Pilzkoma/PiTrac/sp1_vision/strobe_runs/README.md

# Strobe-lit captures

Contents:
- `2026-11-10_first_flash/` — where a flash lands, how bright (below).
- `2026-11-11_triangulation/` — first stereo measurement under the flash
  (last section).

Measured with `sp1_vision/strobe_capture.py`: both cameras stream at 120 fps,
the Teensy fires one pulse from Pin 29 mid-stream, and every frame is logged
with its arrival time after the fire and how far it rose above the run's
ambient baseline. Raw output goes to `/tmp/strobe_<time>/` on the Jetson; only
what a conclusion rests on is kept here.

## 2026-11-10 — first flash, `2026-11-10_first_flash/`

Room light on, ball on the floor in front of the unit, nobody in view, the
arrays' photocells covered. 24 runs: exposure 8 / 4 / 1 ms × single pulse
0.5 / 2 ms × 4 repeats. `frames.csv` holds every frame; the PNGs are run 02
(8 ms exposure, 0.5 ms flash, both cameras) and run 22 (1 ms, 2 ms, cam1).

### The flash swamps room light

Ball centre, mean grey level (sensor black level ≈ 22):

| exposure | flash | cam1 | cam2 |
|---|---|---|---|
| 1 ms, room light only | — | 24 | 22 |
| 8 ms, room light only | — | 36 | 25 |
| 8 ms | 0.5 ms | 237 (saturated) | 118 |
| 8 ms | 2 ms | 244 (saturated) | 234 |
| 1 ms | 2 ms | 244 (saturated) | 131 |

Per unit time the flash puts roughly 50–100× more light on the ball than the
room lamps: a 0.5 ms pulse adds ~95 grey levels at cam2, a whole millisecond of
room light ~2. At 1 ms exposure the room is near black and the ball white.
Even at 8 ms exposure the flash is ~8× the ambient on the ball. Direct sun in
the garage is still untested.

**cam1 saturates on the shortest pulse; cam2 gets about half** — in this run.
It was not the arrays: the right-hand board's photocell was still dimming it
through the tape. With the photocells removed the two cameras agree to 1–2 %
(next section).

### Where the flash lands

- Fire → frame arrival in Python: **11–20 ms**. The 8 ms spread is the frame
  period; the offset is readout + USB + decode.
- **8 ms exposure catches every flash** (16/16), once split across two frames.
- Short exposures catch it by chance, about (exposure + pulse) / 8.33 ms:
  1 ms + 0.5 ms hit 1 of 8 camera-runs.
- **The two cameras are not in phase.** At short exposure one camera often saw
  the flash and the other did not. Triangulation needs both to see the same
  flash, so either the exposure stays long (~8 ms, flash still dominant) or the
  strobe fires a train covering a whole frame period. This is the input for
  `WaitForCam2Trigger`.

### Capture details learned on the way

- Continuous reading needs `CAP_PROP_BUFFERSIZE 2`: with 1 the stream halves to
  ~68 fps, because the frame arriving during a fetch has nowhere to go. The
  held-back-frame defect (CLAUDE.md) only concerns on-demand reads.
- `CAP_PROP_POS_MSEC` (V4L2 buffer timestamp) is unusable here: 4 ms steps and
  occasional jumps of hundreds of ms. Arrival time runs at a steady 8.0 ms.
- Frames are kept as raw MJPEG while streaming (`CAP_PROP_CONVERT_RGB 0`) and
  decoded afterwards; decoding two 120 fps streams in Python drops frames.

### Hardware faults found the same evening

All three made the flash look absent or random before this run:

1. **Two-pole connector on the LED supply** had an intermittent contact —
   replaced with two separate crimps.
2. **Photocells on the Cenpek boards** dim or cut the LEDs in room light (the
   source of the earlier "one array much weaker" and flicker). Covered for
   this run; to be removed for good, since tape will not hold against garage
   daylight.
3. **Trigger line Pin 29 → Teensy Pin 2** dropped out twice and came back while
   probing. To be re-soldered or clamped. Jetson Pin 29 itself was verified
   switching 0 ↔ 3.3 V on the header.

A flash that comes back from a hand or the calibration board held near the
lens reads up to +85 grey levels on the whole frame, so judge strobe
brightness only with an empty scene.

## 2026-11-11 — after the fixes

Photocells desoldered from both boards, trigger line re-soldered. Same scene,
8 ms exposure, 12 runs (raw data only on the Jetson, `/tmp/strobe_run3`).
Both cameras run identical V4L2 settings (gain 0, gamma 100, contrast 32).

- **Trigger: 12/12 flashes arrived, in both cameras.**
- Ball centre (dark level ≈ 24):

  | flash | cam1 | cam2 |
  |---|---|---|
  | 0.1 ms | 140 | 138–139 |
  | 0.3 ms | 238–239 | 237 (once 141) |
  | 0.5 ms | 244 (saturated) | 244 (saturated) |

- **The cameras agree to 1–2 %**; the arrays need no balancing.
- **0.1 ms is already enough** — mid-range on the ball; 0.3 ms clips. Short
  is what a moving ball needs anyway (6 mm of travel per 0.1 ms at 60 m/s).
- The one 141 at 0.3 ms is a flash straddling the ~0.33 ms gap between an
  8.0 ms exposure and the 8.33 ms frame period — about one flash in twenty
  loses part of its light that way.

## 2026-11-11 — the cameras' own processing changes what they report

Brighter room lamps (one lighting the ball from the right, one from above),
same flash, ball in the same place to 5 px. The flash's **contribution** on the
ball — flash frame minus ambient frame, which more ambient light must not
change — dropped:

| 0.1 ms flash, 8 ms exposure | cam1 | cam2 |
|---|---|---|
| dim room (above) | +116 | +114 |
| both lamps on | +53 | +19 |
| lamps off again | +110 | +18 |
| right lamp only | +61 | +19 |
| top lamp only | +93 | +18 |
| after the dashboard ran the cameras on auto exposure | **+108** | **+115** |

Not the arrays (photocells desoldered, both look equal on a phone camera),
not backlight compensation (on/off: no change), not cabling or focus
(re-plugging cam2 did not help). cam2 meanwhile showed a **fixed, soft, round
dark patch over the image centre**, near black in the middle — static over 9 s,
so no insect. It vanished within seconds of the dashboard opening the camera
with auto exposure, and the contribution came back to +115.

Two different things were mixed up in this table, and the first reading
("the processor keeps adapting") was only half right:

1. **cam2's dark patch was a stuck state** in the module's image processor —
   static, with every visible V4L2 control identical to cam1, cleared by one
   auto-exposure pass. Cause unknown.
2. **The lamp effect is a fixed, compressive tone curve, not adaptation.**
   Even after an auto-exposure reset, all lamps on gave +72 / +57 against
   +120 / +118 in the dim room. A gamma sweep under the lamps shows why
   (cam1, 8 ms exposure, ball centre; cam2 alike):

   | gamma | ambient on ball | 0.1 ms flash | 0.2 ms flash | ratio (linear = 2.0) |
   |---|---|---|---|---|
   | **72** (minimum) | 43 | +61 | +107 | **1.75** |
   | 100 (default) | 72 | +62 | +103 | 1.65 |
   | 200 | 138 | +49 | +75 | 1.53 |
   | 500 | 202 | +26 | +39 | 1.47 |

   The higher the ambient puts the ball on the curve, the fewer grey levels
   the same flash adds. Raising `gain` shows the same compression (gain
   0 → 32: ambient above black ×1.8, flash contribution ×1.46).

Consequences, now built into `strobe_capture.py`:
- **Settle on auto exposure before every switch to manual** (against 1).
- **Measure at gamma 72**, the straightest curve the control offers; 100 is
  restored afterwards. With all lamps on: 0.1 ms +65, 0.2 ms +115.
- Grey-level differences are not proportional to light. Comparing flash
  energy across runs needs the same ambient level, or an inverse of the curve
  measured with a pulse series. Detection only needs the ball to stand out,
  which it does.
- Production capture (`V4L2Capture` in `pitrac_lm`) does not set gamma and so
  runs at 100. Worth switching to 72 there too when strobe frames go into
  the C++ path.
- Vendor controls: the modules are Sonix bridges (`0c45:6366`) with two UVC
  extension units, one of them Sonix's undocumented register interface. Not
  touched — nothing above needs it, and writing blind registers can brick a
  module.

## 2026-11-11 — triangulation under the flash, `2026-11-11_triangulation/`

First stereo measurement with strobe-lit pairs and the 2026-11-10
calibration. Captured with `sp1_vision/strobe_pair.py` (one position per
call: 8 ms exposure, 0.2 ms flash, gamma 72, auto-exposure pass first),
analysed unchanged with `python3 -m sp1_vision.cli_triangulate --analyse`.
The shot images in `cam1/`, `cam2/` are **flash minus ambient**, linearly
stretched; `raw/` keeps the flash and ambient frames. The difference is what
makes the detector work: on the plain flash frame with room lamps on, the
patterned carpet gave two "ball-shaped objects".

Layout: a rule on the floor straight out from the unit, zero at camera 1's
lens end, ball centred between the cameras; tape read at the ball's near
edge. Depth line 300–700 mm, plus one position ~16 cm left and one ~14 cm
right at 500 mm. gs_04 was typed as 500 and corrected to 600 in `run.json`
(the ball was at 600; the owner confirmed, and Z says so).

| tape (near edge) mm | 300 | 400 | 500 | 600 | 700 |
|---|---|---|---|---|---|
| Z (ball centre) mm | 361.0 | 462.6 | 558.6 | 659.4 | 762.7 |

- **Scale 1.0003 ± 0.0067**, residual 1.64 mm over 300–700 mm — the
  calibration's metric scale holds under the flash (implied baseline
  80.45 ± 0.54 mm against the file's 80.47). Reprojection 0.01–0.55 px, all
  7 positions found in both cameras.
- **Attitude in the reprinted enclosure:** pitch **+1.60°** (nose up; the old
  enclosure was −1.55°), roll +0.36°, camera 1 **111.9 mm** above the floor;
  plane rms 0.51 mm. The depth line rises +1.61° in camera coordinates,
  echoing the pitch, so the floor is level. Yaw not measured (no target-line
  shots — it describes a session's placement, not the unit).
- Lens-plane offset +60.7 mm. 21.3 mm of that is the ball radius (near-edge
  reading), leaving ~39 mm between the tape's zero and camera 1's optical
  centre — more than an M12 lens suggests. Unresolved whether the zero sat
  exactly at the lens end; it does not affect the scale.
- No repeats, so the scale's stderr is from scatter only.

## 2026-11-12 — continuous strobe, first putts measured, `2026-11-12_putts/`

The answer to "how do both cameras see a ball in flight" (CLAUDE.md item 4):
the cameras free-run out of phase and deliver frames 11-20 ms late, and the
trigger helper alone costs 100-200 ms, so reacting to a hit - PiTrac's way,
which relies on the IMX296's hardware trigger - is impossible here. Instead:

- **Teensy firmware `RUN` / `STOP`** (Hardware/teensy_strobe): repeats the
  active pulse list continuously, safety timeout (default 60 s, cap 10 min)
  and a 25 % duty limit. Built on the Windows box with the Arduino IDE's
  bundled `arduino-cli` (fqbn `teensy:avr:teensy40`; compile from a folder
  holding only the .ino - from the repo folder it fails with "instance is
  no longer valid"), flashed from the Jetson with `flash_teensy.sh` and
  PJRC's `teensy_loader_cli` 2.3 built from source (Ubuntu's 2.1 predates the
  Teensy 4.0; setup in `install_teensy_loader.sh`).
- **`sp1_vision/strobe_shot.py`**: strobe running (2 ms interval, 0.1 ms
  pulses here), both cameras at 8 ms exposure stream into memory, every
  frame saved as the camera's JPEG under `raw/`. The carrier's power LED
  blinks fast while recording (`sp4_gspro/jetsonlm-led`, sudoers entry from
  `install_system_permissions.sh`).
- **`sp1_vision/strobe_event.py`**: finds the shot afterwards - rest ball by
  the stereo search, impact when its image position stays dark, reference
  from 0.08-0.25 s before impact, ball in the POSITIVE difference after it,
  stereo-checked, and a robust constant-velocity fit (≥ 6 positions within
  15 mm, faster than 0.3 m/s) to reject the circles that feet and putter
  still sneak past the stereo checks.

What did not work first: a reference from the first half second (player
still in frame), a whole-recording median (player in frame most of the
time - "balls" everywhere), and scoring by moving area (the player's legs
win). With the player in FRONT of the ball one of three putts survived;
standing behind it, all three did.

Putts, 2026-11-12 (25 s recording, player behind the ball, one ball orange -
indistinguishable at 850 nm):

| putt | speed | direction | positions on the line | rms |
|---|---|---|---|---|
| 1 | 1.06 m/s | across, 4.2° away from the unit | 17 of 29 | 7.4 mm |
| 2 | 1.25 m/s | across, 3.4° away | 14 of 21 | 8.4 mm |
| 3 | 1.39 m/s | across, 2.5° away | 15 of 25 | 8.7 mm |

Rest ball at X −117, Y +103, Z 406 mm each time (Y on the measured floor).
A fourth candidate (0.10 m/s, the ball being put back) was rejected. The
`shotN.json` files hold every position; the sheets show the accepted frames.
The raw recording (~500 MB) stays on the Jetson in `/tmp/shot3`.

Open: the analysis is offline Python (5 min for 25 s); the device must
watch a small window round the rest ball as frames arrive. Frame times are
arrival times and the two cameras' frames are up to 4 ms apart - fine for a
putt, not for a drive, where the flash pattern has to identify the ball
images instead. Short pulses for fast balls (blur) still to be measured.

## 2026-11-12 (night) — chips, free-running and hardware-triggered

Raw recordings stay on the Jetson under `/home/brain/strobe_raw/` (no longer
`/tmp`, which a reboot cleared - the putt recording was lost that way).

**Free-running, 4 ms flash interval** (`2026-11-12_chips`, 45 s, 1.1 GB):
`strobe_event` needed over 50 min before `b3a3fcc` (find_impacts rescanned
to the end for every rest sample - quadratic). It then found the rest ball
(X −78, Z 440 mm) but 11 "impacts" for 3 chips, and on chip 1 the ball in
two frame pairs only (≈ 4-5 m/s, two points, rough). The contact sheet
shows why: two flashes fall into each 8 ms frame and at chip speed their
ball images (~18 mm apart, 43 mm ball) merge into one elongated blob that
the circle search rejects. Stopped.

**Hardware trigger** (`2026-11-12_chips_trigger`, 45 s, 332 MB): the B0332
trigger input (pad F, see LOGBOOK / CLAUDE.md) on Teensy pins 4/5,
firmware v0.3 `TRIG_RUN`, `strobe_shot --trigger`: 0.5 ms exposure, an
edge every 10 ms (100 fps, the most the cameras follow - at 105 fps they
take every other edge, `trigger_rate.py`), a 100 µs flash 0.9 ms after
each edge (exposure starts 0.78 ms after the edge in both cameras within
25 µs, `trigger_sweep.py`). 4512 edges, 4512 frames per camera; one round,
sharp ball per frame on a nearly black background, the ball's print
visibly turning frame to frame.

`strobe_event` is not yet adapted to these frames: its rest search found
the dimmer rest ball at only 4 of ~180 moments (2 of 3 chips found) and
its flight search ran 34 min on chip 1 without output (stopped,
unexamined). Next: bound the flight search to a window round the expected
path, consider a 200-300 µs flash for the rest ball, frame times from the
trigger index instead of arrival.

**2026-11-13: `strobe_event` adapted** (`4a395d2`, `405a0f4`), three causes,
each measured first: (1) a ball-free difference image's ~9 grey levels of
noise were scaled to 220 - 1768 x 1577 Hough circles, ~280 s of pairing per
frame; now a floor of 100 on the scale plus `max_candidates`; (2) the rest
ball's soft edge (Sobel median 19 vs Canny 100) - dark frames brightened
x2.5 for the rest search, 0 → 16 of 17; (3) the ball in flight climbed over
the optical axis and the resting-ball height band refused it -
`find_ball_pair(in_flight=True)`. The whole recording now takes 147 s:

| chip | speed | launch* | direction | points | rms |
|---|---|---|---|---|---|
| 1 | 4.82 m/s | ≈ 33° | 2.4° towards the unit | 7/7 | 5.5 mm |
| 2 | 4.86 m/s | ≈ 36° | 0.7° towards | 5/6, rejected (min 6) | 2.2 mm |
| 3 | 3.91 m/s | ≈ 36° | 1.7° towards | 7/8 | 6.4 mm |

*by hand from first/last position plus the unit's +1.6° pitch.

The ball leaves the IR beam before it leaves the image: its residual falls
106 → 85 → 67 → 44 → 33 → 23 → 9 over 0.1 s while it is still ~100 mm
below the image top. The arrays light too flat for higher launches.

## 2026-11-13 — short-pulse test, `2026-11-13_pulse_test/`

Static ball at Z 443 mm (radius 44 px), trigger mode, 0.5 ms exposure,
gamma 72, flash 0.9 ms after the edge, 4 flash shots per pulse each followed
by a dark shot; frames matched by arrival time, alignment proven
(`shot_frames.py` / `shot_analyse.py`, numbers in `results.txt`). Ball minus
surround, cam1 / cam2: 10 µs +17 / +17, 20 µs +34 / +34, 30 µs +50 / +49,
50 µs +75 / +75, 100 µs +123 / +124, saturated from 200 µs - about 1.6 grey
levels per µs. 10 µs already shows the ball, 20-30 µs clearly.

Dimples: undecided - a cellular texture at 100 µs and a scalloped rim at
200 µs, but MJPEG's 8x8 blocks are about a dimple's size; settle it with
PiTrac's Gabor filter on these crops, not by eye. Ink (`ink_crops.png`):
of several pens only the thick middle stroke is clearly dark at 850 nm.

A first run the same day read "the next frame" after each SHOT and got
frames from before trigger mode or from the previous shot; it halved every
figure and claimed "no dimples" from crops of the wrong pulse. Withdrawn.

## 2026-11-13 — dimple test, `2026-11-13_dimple_test/`

Does PiTrac's dimple map carry a known rotation on our images? A resting
ball, captured unmoved and turned by hand about the vertical axis (true
turn from the pen stroke: −12° cam1, −8..−9° cam2). `dimple_test.py`
reproduces PiTrac's front-end and scores A's map, turned on the sphere by
φ, against B's. Dimples only: no peak near the true turn (best +24° / +38°,
wrong sign, at the search edge). Control with the stroke left in: peak at
−16..−18°. The maps do not carry the rotation; spin needs IR-dark marks and
a mark-based method. Numbers in `results.txt`.
