Pilzkoma/PiTrac/sp1_vision/strobe_runs/2026-11-10_first_flash/run02_cam1_flash.png

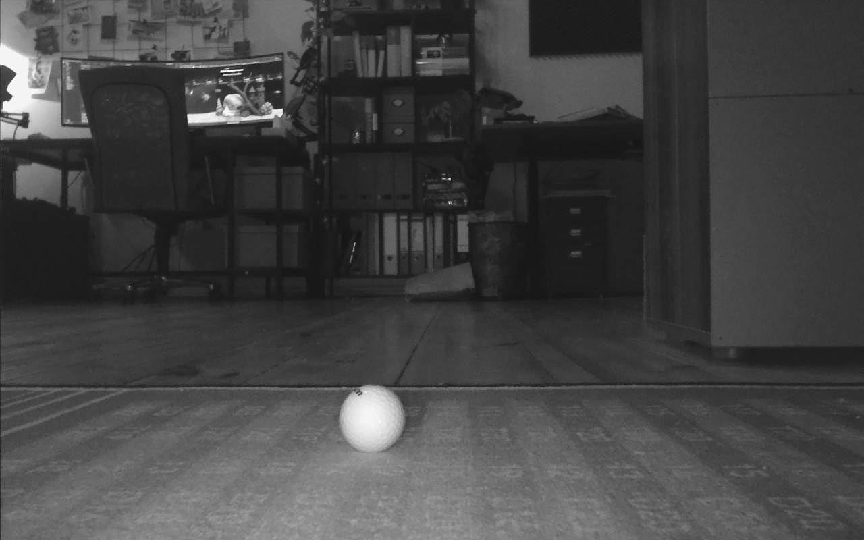
sp1_vision/strobe_runs/2026-11-10_first_flash/run02_cam1_flash.png
