Pilzkoma/PiTrac/sp1_vision/strobe_runs/2026-11-11_triangulation/cam1/gs_01.png

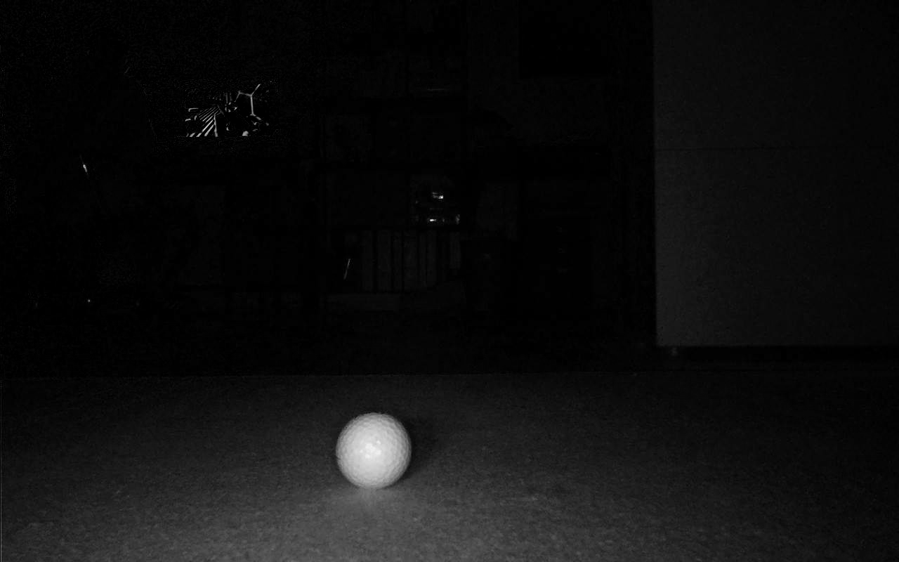
sp1_vision/strobe_runs/2026-11-11_triangulation/cam1/gs_01.png
