Pilzkoma/PiTrac/sp1_vision/strobe_runs/2026-11-11_triangulation/cam2/gs_02.png

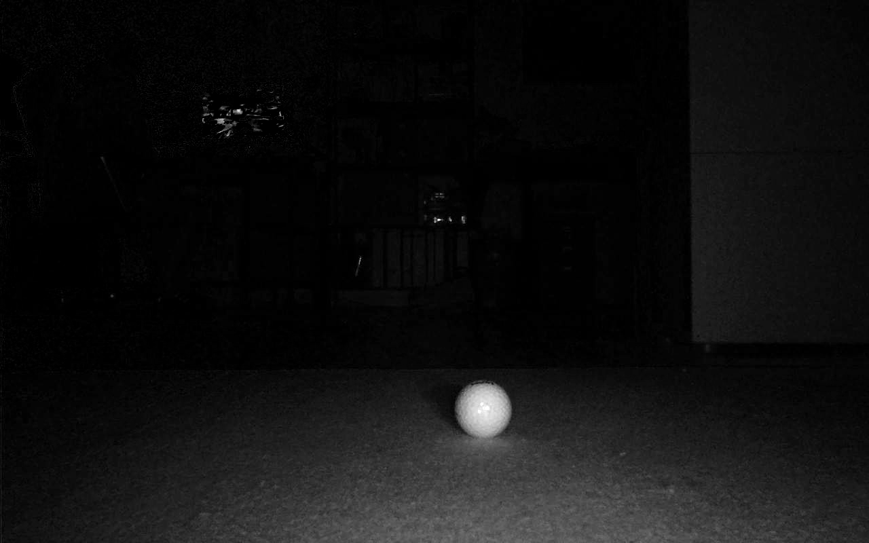
sp1_vision/strobe_runs/2026-11-11_triangulation/cam2/gs_02.png
