Pilzkoma/PiTrac/sp1_vision/strobe_runs/2026-11-11_triangulation/cam2/gs_07.png

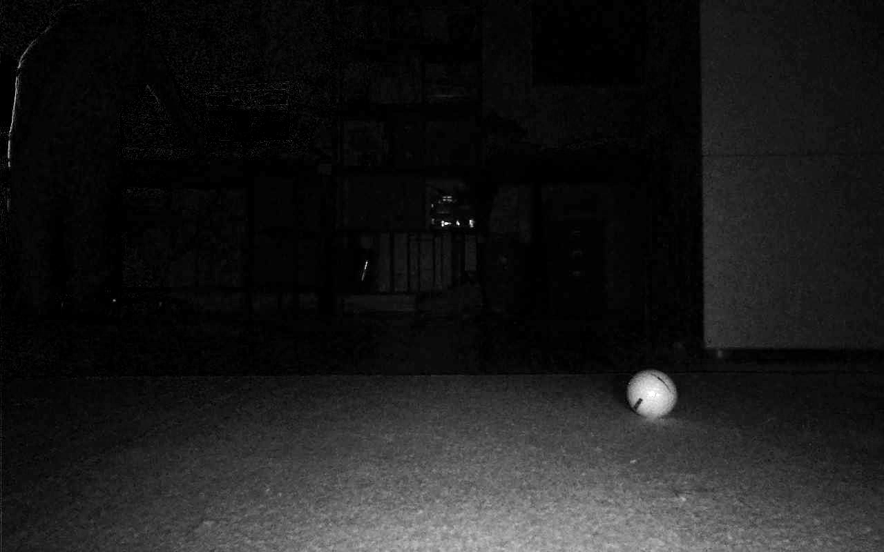
sp1_vision/strobe_runs/2026-11-11_triangulation/cam2/gs_07.png
