Pilzkoma/PiTrac/sp1_vision/strobe_runs/2026-11-11_triangulation/raw/cam1/gs_07_ambient.png

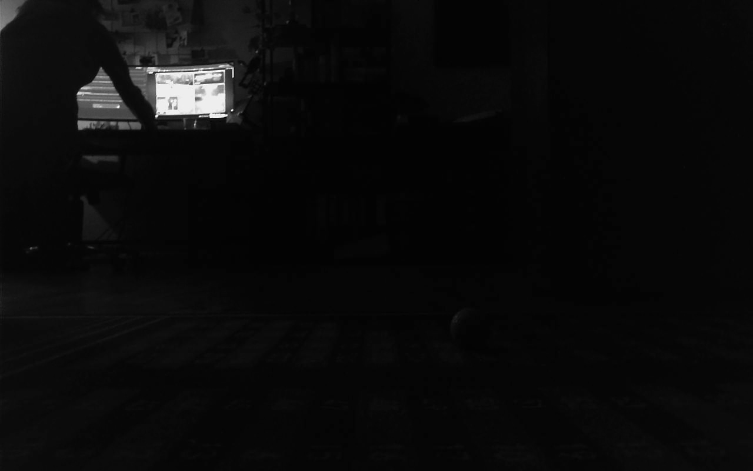
sp1_vision/strobe_runs/2026-11-11_triangulation/raw/cam1/gs_07_ambient.png
