Pilzkoma/PiTrac/sp1_vision/strobe_runs/2026-11-11_triangulation/raw/cam2/gs_03_ambient.png

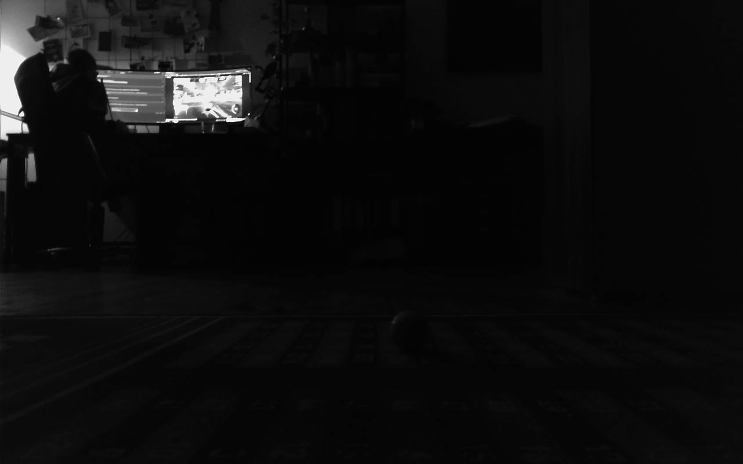
sp1_vision/strobe_runs/2026-11-11_triangulation/raw/cam2/gs_03_ambient.png
