Pilzkoma/PiTrac/sp1_vision/strobe_runs/2026-11-12_putts/shot2_cam1.png

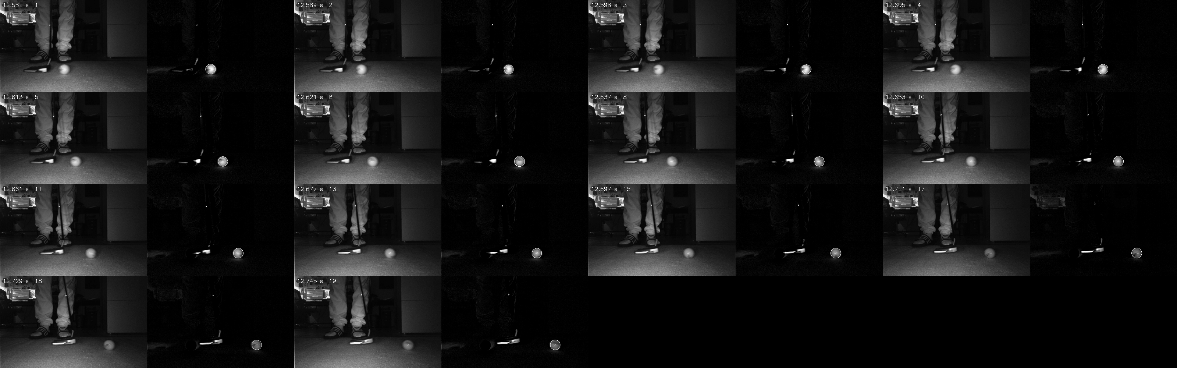
sp1_vision/strobe_runs/2026-11-12_putts/shot2_cam1.png
