Pilzkoma/PiTrac/sp1_vision/calibration_images/2026-11-10_bent_board/cam1/gs_14.png

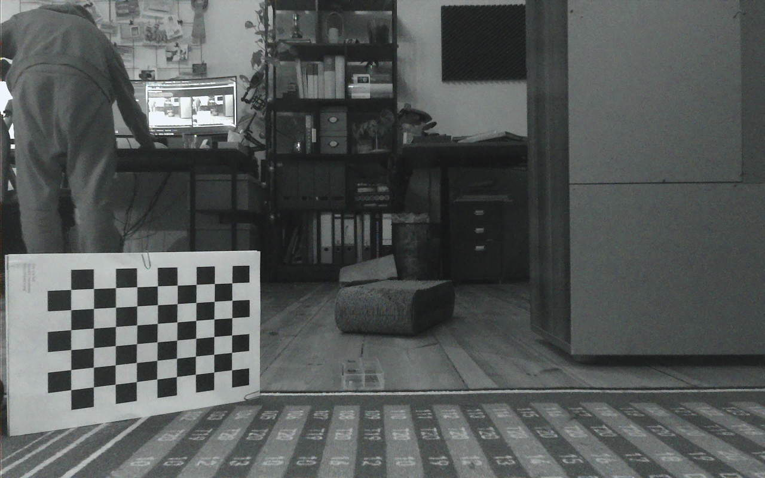
sp1_vision/calibration_images/2026-11-10_bent_board/cam1/gs_14.png
