Pilzkoma/PiTrac/sp1_vision/calibration_images/2026-11-10_bent_board/cam2/gs_10.png

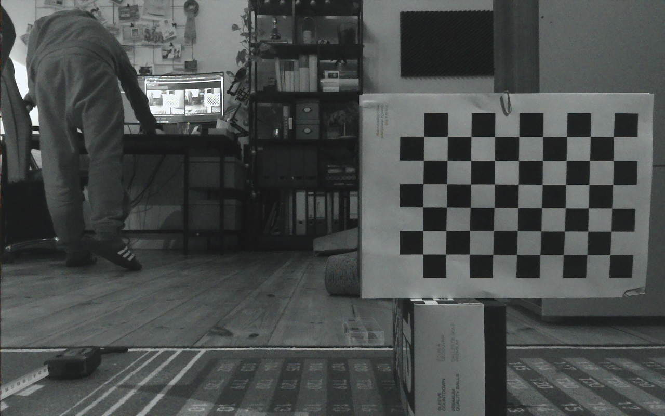
sp1_vision/calibration_images/2026-11-10_bent_board/cam2/gs_10.png
