Pilzkoma/PiTrac/sp1_vision/calibration_images/cam1/gs_06.png

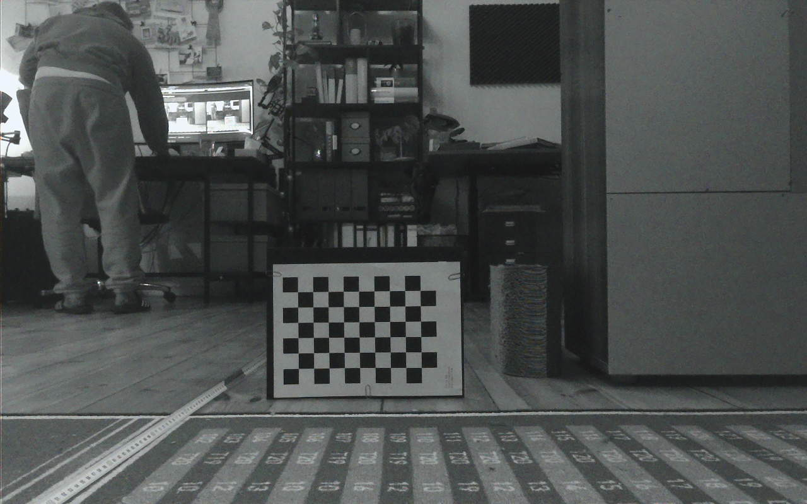
sp1_vision/calibration_images/cam1/gs_06.png
