Pilzkoma/PiTrac/sp1_vision/calibration_images/cam1/gs_13.png

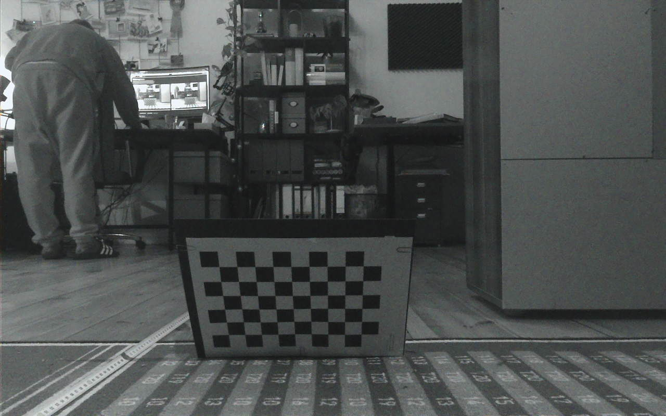
sp1_vision/calibration_images/cam1/gs_13.png
