Pilzkoma/PiTrac/sp1_vision/calibration_images/cam1/gs_25.png

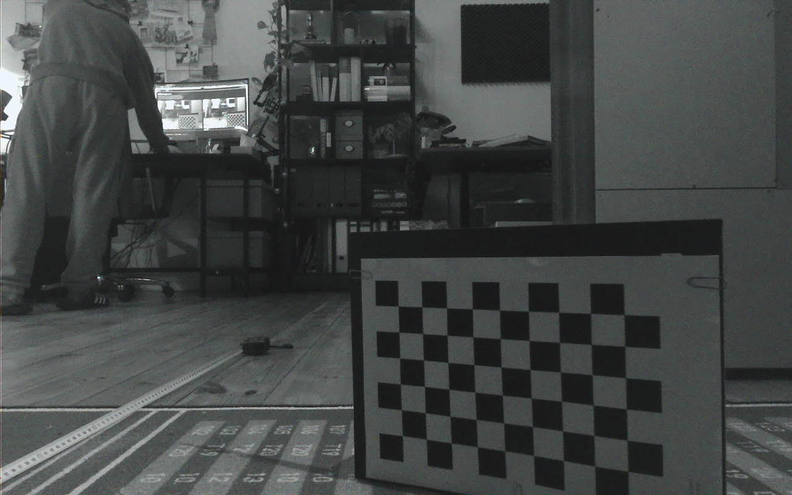
sp1_vision/calibration_images/cam1/gs_25.png
