Pilzkoma/PiTrac/sp1_vision/calibration_images/cam1/gs_31.png

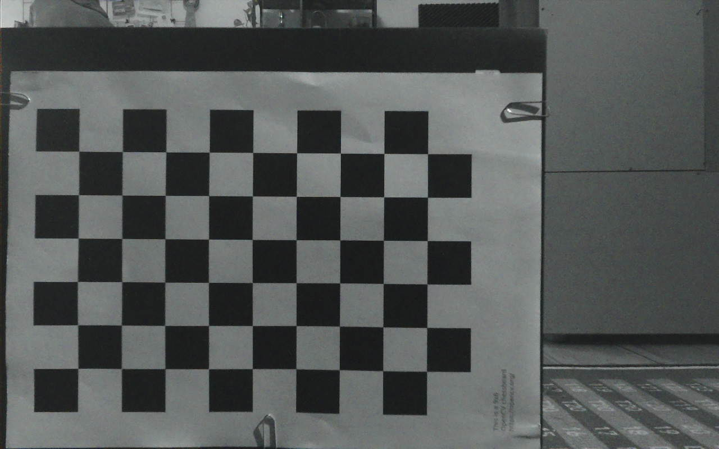
sp1_vision/calibration_images/cam1/gs_31.png
