Pilzkoma/PiTrac/sp1_vision/calibration_images/cam2/gs_08.png

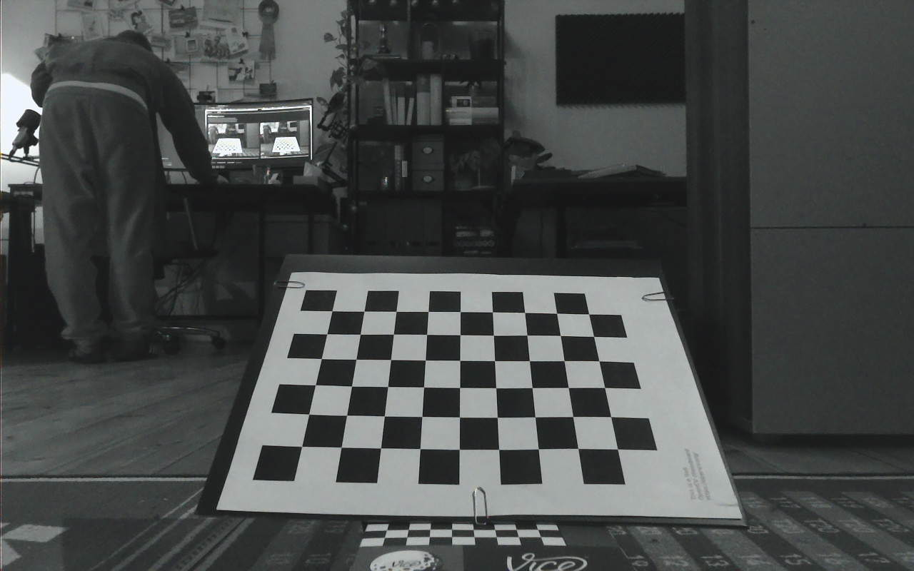
sp1_vision/calibration_images/cam2/gs_08.png
