Pilzkoma/PiTrac/sp1_vision/calibration_images/cam2/gs_17.png

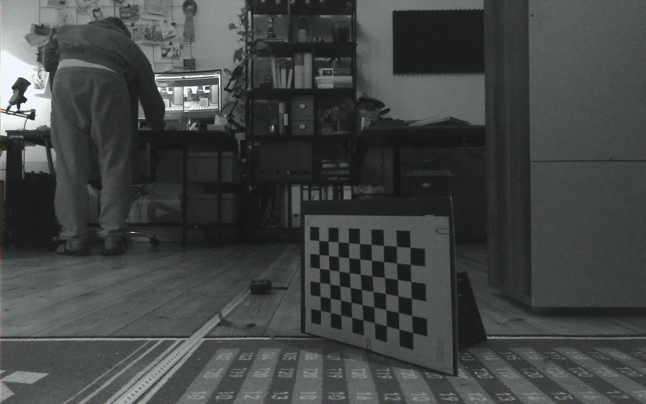
sp1_vision/calibration_images/cam2/gs_17.png
