Pilzkoma/PiTrac/sp1_vision/calibration_images/cam2/gs_19.png

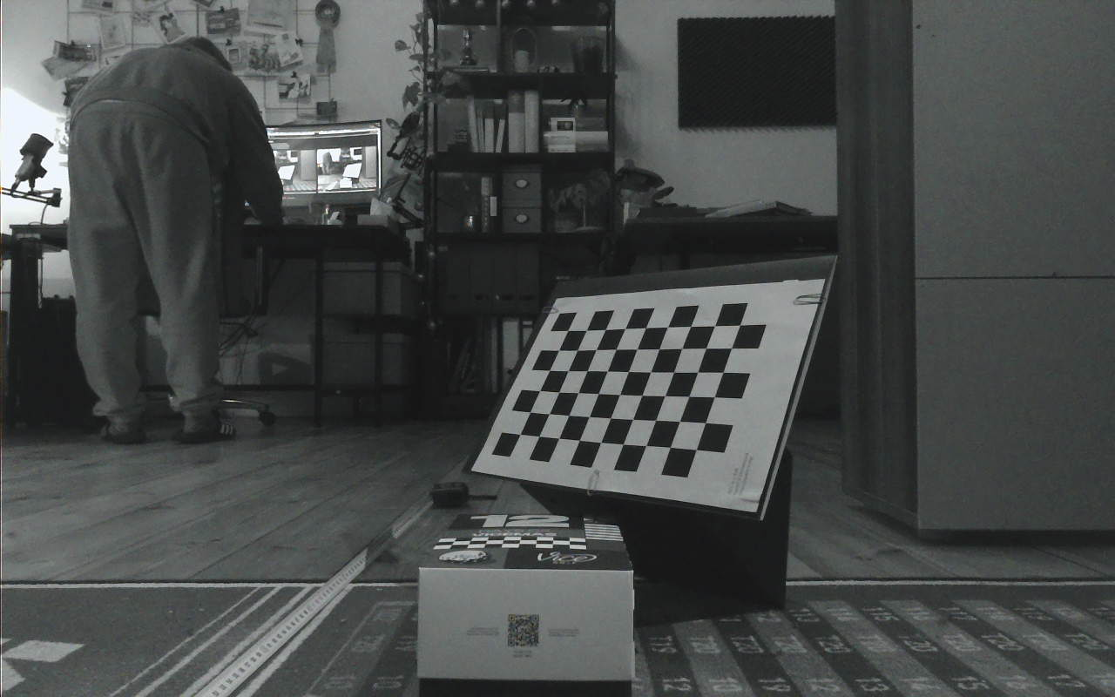
sp1_vision/calibration_images/cam2/gs_19.png
