Pilzkoma/PiTrac/sp1_vision/calibration_images/cam2/gs_20.png

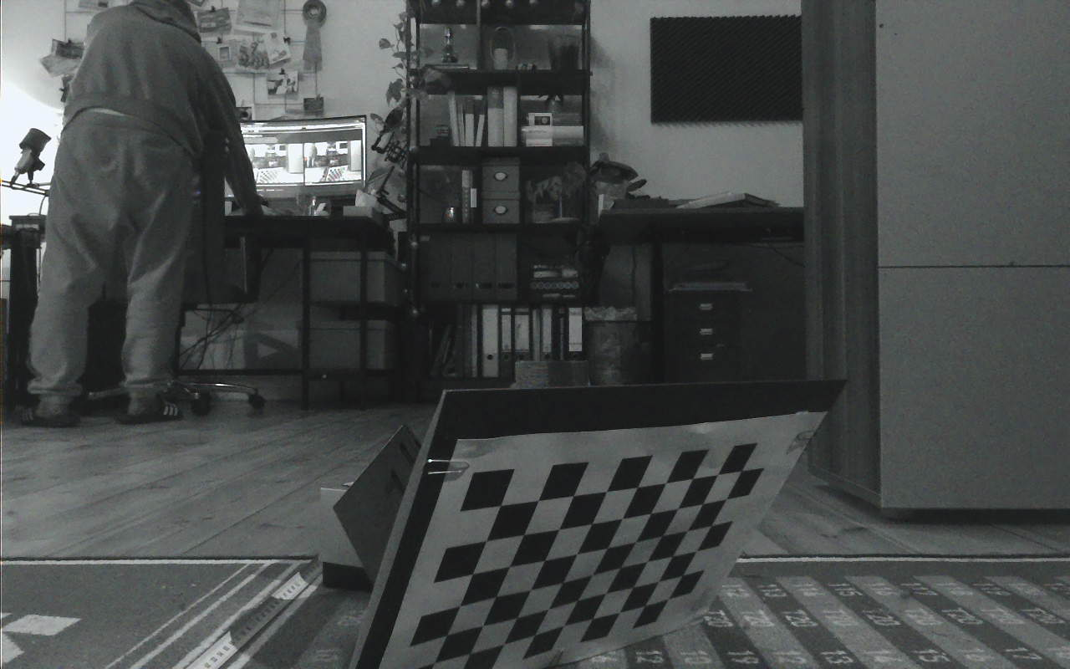
sp1_vision/calibration_images/cam2/gs_20.png
