Pilzkoma/PiTrac/sp1_vision/calibration_images/cam2/gs_25.png

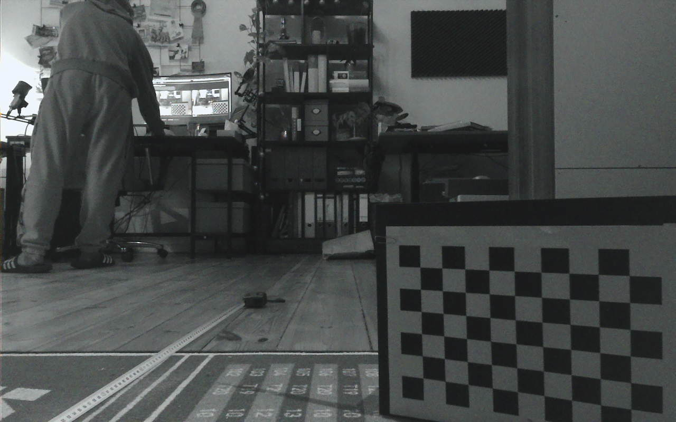
sp1_vision/calibration_images/cam2/gs_25.png
