Pilzkoma/PiTrac/sp1_vision/strobe_runs/2026-11-13_dimple_test/dimple_maps_control_marks_kept.png

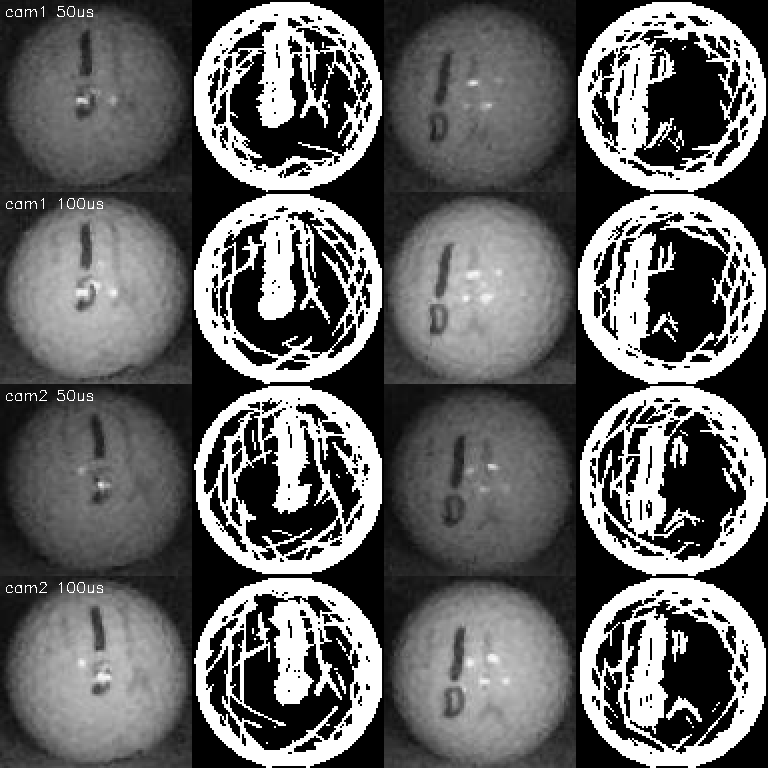
sp1_vision/strobe_runs/2026-11-13_dimple_test/dimple_maps_control_marks_kept.png
