Pilzkoma/PiTrac/sp1_vision/strobe_runs/2026-11-13_pulse_test/pulse_crops.png

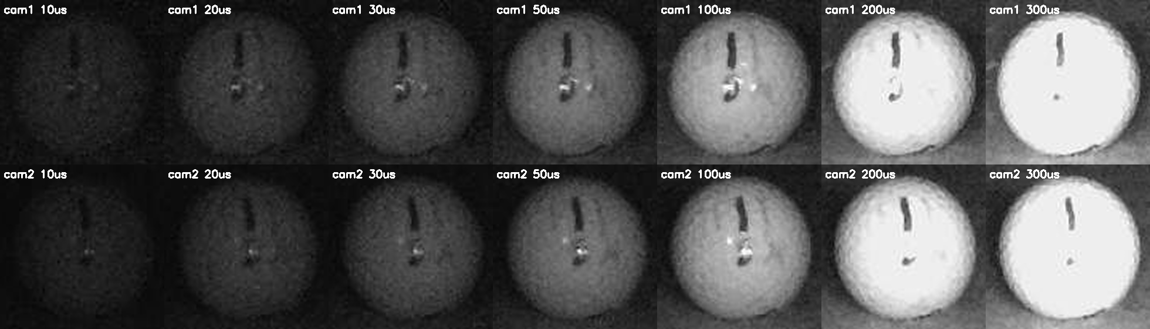
sp1_vision/strobe_runs/2026-11-13_pulse_test/pulse_crops.png
