Pilzkoma/PiTrac/sp1_vision/tests/fixtures/ball_pairs/far_ball_on_towel/cam2.png

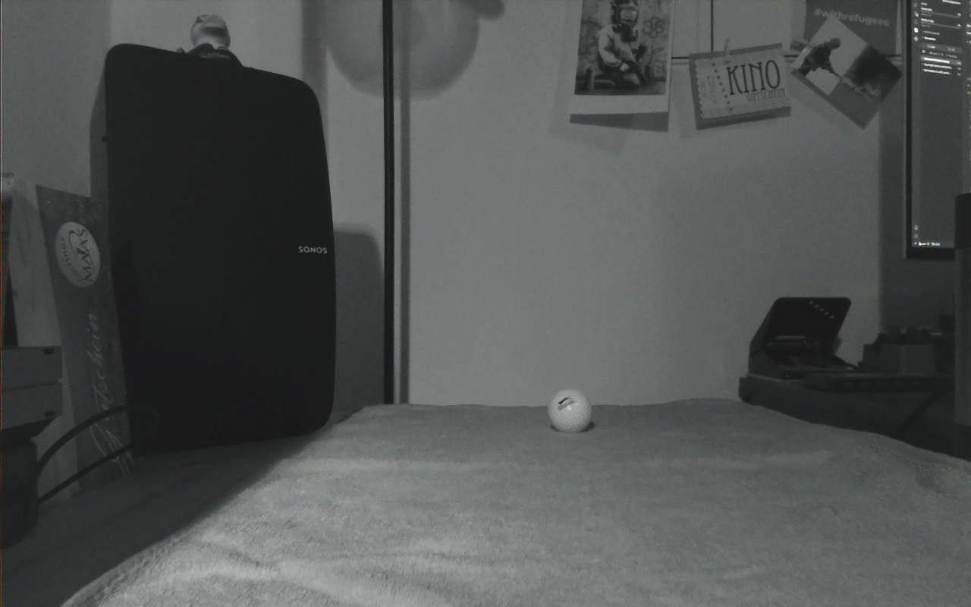
sp1_vision/tests/fixtures/ball_pairs/far_ball_on_towel/cam2.png
