Pilzkoma/PiTrac/Software/LMSourceCode/ImageProcessing/camera_hardware.h

/* SPDX-License-Identifier: GPL-2.0-only */
/*
 * Copyright (C) 2022-2025, Verdant Consultants, LLC.
 */

// Attempts to hide some details about the specific camera hardware in use.
// Coding for any new cameras should start here

#pragma once

#include <string>
#include "logging_tools.h"
#include "cv_utils.h"
#include "gs_globals.h"
#include "gs_options.h"

namespace golf_sim {

    class CameraHardware {

    public:

        // If set to >0, init_camera_parameters will use these values instead of camera-model-specific values
        // That way, if you want to use an image with X,Y resolution different than the current camera, you
        // can sort of make-believe that a camera with just your X,Y resolution took the picture.
        // TBD - Should not be static
        static int resolution_x_override_;
        static int resolution_y_override_;

        // Physical sensor size in mm, same override mechanism. Needed because
        // the model-specific values below assume a camera this build does not
        // have: the PiGS branch hardcodes the IMX296's 5.077 x 3.789 mm, and
        // overriding only the resolution leaves the sensor's aspect ratio
        // disagreeing with the image's. That skews the vertical world-coordinate
        // maths in gs_camera.cpp, and does it consistently enough to look
        // plausible. Set to <= 0 to keep the model-specific value.
        static float sensor_width_override_mm_;
        static float sensor_height_override_mm_;

        int CAMERA_NUM_PICTURES_TO_TAKE = 2;

        enum CameraModel {
            PiCam13 = 1,
            PiCam2 = 2,
            PiHQ = 3,
            PiGS = 4,
            InnoMakerIMX296GS_Mono = 5,
            kCameraUnknown = 100
        };

        enum LensType {
            Lens_6mm = 1,
            Lens_3_6mm_M12 = 2,
            Lens_Custom = 3,
            kLensUnknown = 100
        };

        // An initial set of states to simulate a camera repeatedly taking pictures until
        // (at some point in time), the object of interest in the image changes.
        // Was used to test the camera 1 movement processing.
        enum TestVideoState {
            ImagesLoaded,
            TakingInitialStaticFrames,
            FirstMovementFrame,
            BallGoneFrames
        };

		// kUpsideUp means the camera is mounted normally, kUpsideDown means the camera is upside down
		// The "normal" orientation depends on the specific camera model, but means that when you use rpicam-still or
		// other utilities to take a picture, the image appears right-side up.
        enum CameraOrientation {
            kUpsideUp = 1,
            kUpsideDown = 2,
            kCameraOrientationUnknown
        };

        // This is the camera number from the perspective of the PiTrac system.
        // So kGsCamera1 is the camera that watches the teed-up ball, and 
        // kGsCamera2 is the camera that images the ball in flight
        GsCameraNumber camera_number_ = GsCameraNumber::kGsCamera1;

        CameraModel camera_model_ = CameraModel::PiGS;
        LensType lens_type_ = LensType::Lens_6mm;
		CameraOrientation camera_orientation_ = CameraOrientation::kCameraOrientationUnknown;

        float focal_length_ = 0;        // In millimeters
        float sensor_width_ = 0;        // The physical size of the camera sensor, inclusive of all the pixels.  In mm
        float sensor_height_ = 0;       // In mm

        bool use_undistortion_matrix_ = false;

        cv::Mat calibrationMatrix_;
        cv::Mat cameraDistortionVector_;

        // These SHOULD depend on camera model
        // -1 if not set via init_camera_parameters or otherwise overridden
        int resolution_x_ = -1;
        int resolution_y_ = -1;

        // For some cameras, the video resolution may be different (and 
        // typically lower) than the still-picture resolution
        int video_resolution_x_ = -1;
        int video_resolution_y_ = -1;

        cv::Vec2d camera_angles_;

        // Will be set to a reasonable default based on the camera in use
        // Can be overridden from the .json config file using either of 
        // kExpectedBallRadiusPixelsAt40cmCamera1 or 2
        int expected_ball_radius_pixels_at_40cm_ = 0;

        // if set, the camera will use this image (file) as if (it were the image that the
        // camera took on the Pi, regardless of operating system.  First will be used first, then
        // if another picture is needed, the second will be used.
        std::string firstCannedImageFileName;
        std::string secondCannedImageFileName;

        cv::Mat firstCannedImage;
        cv::Mat secondCannedImage;

        // true; if the camera is all ready to go to take a picture.
        bool cameraReady = false;

        CameraHardware();
        ~CameraHardware();

        static CameraModel string_to_camera_model(const std::string& model_enum_value_string);
        static LensType string_to_lens_type(const std::string& lens_enum_value_string);
        static CameraOrientation string_to_camera_orientation(const std::string& lens_enum_value_string);

        bool camera_is_mono() const;

        // Used when using test images instead of live photos
        // Pre-loads the test images to allow for faster simulated returns of them
        void load_test_images();

        void init_camera();
        void deinit_camera();

        void init_camera_parameters(const GsCameraNumber camera_number, 
                                    const CameraModel model, 
                                    const LensType lens_type,
                                    const CameraOrientation orientation,
                                    const bool use_default_focal_length = false);

        bool prepareToTakePhoto();
        cv::Mat take_photo();

        bool prepareToTakeVideo();
        cv::Mat getNextFrame();

        // TBD - Probably should be private, but the higher-level golf_sim_camara needs to check this sometimes
        bool cameraInitialized = false;

    private:

        // Counts the number of static images that have been sent so far if this camera is
        // being emulated by software to take the place of a real camera.
        int staticImagesSent = 0;

        TestVideoState testVideoState = TestVideoState::ImagesLoaded;
        int currentStaticImageIndex = 0;
    };

}
