Pilzkoma/PiTrac/sp1_vision/cli_triangulate.py

#!/usr/bin/env python3
"""Capture and analyse a triangulation measurement series.

Capture:  python3 -m sp1_vision.cli_triangulate --shots 24 --out RUNDIR
Analyse:  python3 -m sp1_vision.cli_triangulate --analyse RUNDIR

The layout, the setup and how to read the rule are in
sp1_vision/triangulation_run/PROTOCOL.md - follow that, not memory.

Each shot: type the reading, type the series (d / s / t), make sure nobody
is in frame, press Enter. The frame is taken AFTER that Enter. Check the
line that comes back: Z a little beyond the mark, Y positive, size small.

The ball lies on the surface, never on the rule; read its NEAR edge.
Re-place it between repeats - repeats without touching it share the same
detector bias and only shrink the printed uncertainty, not the error.
"""

import argparse
import json
import os
import re
import sys
import tempfile

import cv2
import numpy as np

from sp1_vision import (ball_pair, calibration_capture, frame_analysis,
                        ground_plane,
                        stereo_geometry, triangulate)

RUN_MANIFEST = "run.json"

# --refiner for --analyse. One method for a whole run: on run 6
# (2026-09-24), falling back per shot from one to the other moved the
# fitted scale from 0.961 to 0.931.
REFINERS = {
    "canny": frame_analysis.refine_ball,
    "contrast": frame_analysis.refine_ball_by_contrast,
}


def _ask_float(prompt):
    while True:
        raw = input(prompt).strip()
        try:
            return float(raw)
        except ValueError:
            print("  need a number, e.g. 420.5")


SERIES = {"d": "depth", "s": "spread", "t": "target"}

# Spelt out at every shot rather than once at the top, because two ways of
# reading a rule differ by a few millimetres and the whole baseline question
# is 0.6%. The NEAR EDGE rather than the ball's centre because an edge is a
# sharp thing to sight and a centre is a judgement, and the resulting
# constant offset of one ball radius lands in the fit's intercept, where it
# costs nothing. What must not vary is WHICH edge: always the one facing the
# unit, at every position, for the whole series.
TAPE_PROMPT = ("  reading on the rule at the ball's NEAR edge (the side\n"
               "  facing the unit), mm: ")


def _ask_series():
    """Which of the three series this position belongs to.

    Asked rather than inferred because the three are consumed differently and
    no amount of after-the-fact geometry recovers the distinction reliably.
    """
    while True:
        raw = input("  series - [d]epth line / [s]pread / [t]arget line: ")
        key = raw.strip().lower()[:1]
        if key in SERIES:
            return SERIES[key]
        print("  answer d, s or t")


def _find_max_shot_number(cam_dir):
    """Return the highest gs_NN number found in the directory, or 0.

    Used to detect when the manifest and disk have diverged.
    """
    if not os.path.exists(cam_dir):
        return 0
    max_num = 0
    for entry in os.listdir(cam_dir):
        match = re.match(r"^gs_(\d+)\.png$", entry)
        if match:
            max_num = max(max_num, int(match.group(1)))
    return max_num


REQUIRED_SHOT_FIELDS = (("name", str), ("tape_mm", (int, float)),
                        ("series", str))


def _shot_problem(shot):
    """Return a description of what is wrong with a manifest entry, or None.

    Structural validation only - it does not check that "series" is one of
    the three known labels, because run_analysis already prints an
    unknown-series row for that and carries on, which is the better answer
    for a typo'd label.
    """
    if not isinstance(shot, dict):
        return "is {}, not an object".format(type(shot).__name__)
    for key, expected in REQUIRED_SHOT_FIELDS:
        if key not in shot:
            return 'has no "{}"'.format(key)
        value = shot[key]
        if isinstance(value, bool) or not isinstance(value, expected):
            return '"{}" is {}, not {}'.format(
                key, repr(value),
                "a number" if key == "tape_mm" else "a string")
    return None


def _load_manifest(out_dir):
    """Load run.json from out_dir, returning its shots list.

    Returns an empty list if no manifest exists yet - that is the normal
    state for a brand-new run directory, not an error. A manifest that
    exists but cannot be parsed, or parses without a "shots" key, is a
    different situation: the tape readings it should hold cannot be
    reconstructed from the images alone, so this prints an operator-facing
    message naming the run directory and exits rather than guessing.

    Each entry is then checked for the three fields everything downstream
    indexes. A hand-edited manifest is not a hypothetical - the resume
    warning above tells the operator the file and the images disagree, and
    editing run.json is what they will do about it. A missing "tape_mm"
    would otherwise surface as a bare KeyError halfway down the analysis
    table, a long way from the file that caused it and from this message,
    which is the one written for them.
    """
    manifest_path = os.path.join(out_dir, RUN_MANIFEST)
    if not os.path.exists(manifest_path):
        return []
    try:
        with open(manifest_path) as fh:
            shots = json.load(fh)["shots"]
        if not isinstance(shots, list):
            raise TypeError('"shots" is {}, not a list'.format(
                type(shots).__name__))
    except (json.JSONDecodeError, KeyError, OSError, TypeError) as e:
        print("ERROR: run.json in {} is corrupt or unreadable: {}".format(
            out_dir, e))
        print("  The images on disk are still present.")
        print("  The tape readings for this run are lost.")
        sys.exit(1)

    problems = []
    for i, shot in enumerate(shots):
        problem = _shot_problem(shot)
        if problem is not None:
            problems.append("  shot {} (entry {}) {}".format(
                shot.get("name", "?") if isinstance(shot, dict) else "?",
                i, problem))
    if problems:
        print("ERROR: run.json in {} is readable but {} of its {} entries "
              "are incomplete:".format(out_dir, len(problems), len(shots)))
        for line in problems:
            print(line)
        print('  Every entry needs "name", "tape_mm" and "series".')
        print("  The images on disk are still present; fix the entries or "
              "delete them.")
        sys.exit(1)
    return shots


def _write_manifest(out_dir, shots):
    """Atomically (re)write run.json in out_dir with the given shots list.

    Writes to a temp file in the same directory - so os.replace is atomic
    even if out_dir is a different filesystem from the system temp dir -
    then replaces the manifest in one step. If anything raises before the
    replace, the temp file is removed and the previous manifest, if any, is
    left untouched.
    """
    manifest_path = os.path.join(out_dir, RUN_MANIFEST)
    fd, temp_path = tempfile.mkstemp(dir=out_dir, suffix=".tmp")
    try:
        with os.fdopen(fd, "w") as fh:
            json.dump({"shots": shots}, fh, indent=2)
        os.replace(temp_path, manifest_path)
    except Exception:
        try:
            os.unlink(temp_path)
        except OSError:
            pass
        raise


def _resume_start_number(dirs, shots):
    """Decide the next shot number to use when resuming into an existing run.

    Compares the highest gs_NN number found on disk (in cam1's directory)
    against the number of shots already recorded in the manifest. A crash
    between writing an image pair and writing the manifest entry for it can
    leave these disagreeing in either direction; starting from the max of
    the two is the only choice that never overwrites an existing image.
    Divergence is reported naming both counts, since it means the run
    directory saw a crash and is worth a second look regardless.
    """
    max_on_disk = _find_max_shot_number(dirs[1])
    max_in_manifest = len(shots)
    if max_on_disk != max_in_manifest:
        print("WARNING: manifest has {} shots but disk has images up to gs_{:02d}".format(
            max_in_manifest, max_on_disk))
        if max_on_disk > max_in_manifest:
            print("  Restarting numbering from gs_{:02d}".format(max_on_disk + 1))
    return max(max_on_disk, max_in_manifest) + 1


def run_shots(count, out_dir, exposure_units,
              extrinsics_path=stereo_geometry.DEFAULT_EXTRINSICS_PATH,
              config_path=stereo_geometry.DEFAULT_CONFIG_PATH):
    # Capture needs the rig now, because verifying that the thing in frame
    # is a BALL and not a loudspeaker is a stereo question - it takes the
    # baseline to turn two circles into a distance and a size. Loading it
    # here means a bad rig stops the session before the first shot instead
    # of after the twenty-fourth.
    try:
        rig = stereo_geometry.load_rig(extrinsics_path, config_path)
        stereo_geometry.validate_rig(rig)
    except stereo_geometry.StereoRigError as e:
        print("ERROR: {}".format(e))
        return 1

    dirs = {n: os.path.join(out_dir, "cam{}".format(n)) for n in (1, 2)}
    for d in dirs.values():
        os.makedirs(d, exist_ok=True)

    shots = _load_manifest(out_dir)
    if shots:
        print("{} shots already in {} - new ones are numbered after them."
              .format(len(shots), out_dir))

    start_num = _resume_start_number(dirs, shots)

    print(__doc__)
    with calibration_capture.CameraPair(exposure_units=exposure_units) as pair:
        for i in range(start_num, start_num + count):
            name = "gs_{:02d}.png".format(i)
            print("\n--- shot {} ---".format(i))
            tape_mm = _ask_float(TAPE_PROMPT)
            series = _ask_series()
            input("  place the ball, stand clear, press Enter: ")

            frames, skew = pair.grab_with_skew()
            for n, frame in frames.items():
                cv2.imwrite(os.path.join(dirs[n], name), frame)

            # The check that used to live here reported "ball" whenever a
            # circle was found in each image separately. It validated
            # nothing: on 2026-08-10 it said ball / ball / keep for 24
            # consecutive shots while both cameras measured a loudspeaker,
            # and the run was only discovered to be worthless at analysis
            # time, with the tape measure long since put away. What follows
            # is the SAME decision the analysis makes, made now, so that a
            # shot that will be rejected is rejected while the operator is
            # still standing there.
            ball, reason = ball_pair.find_ball_pair(rig, frames[1], frames[2])
            both = ball is not None
            if both:
                print("  BALL at Z {:.0f} mm  (X {:+.0f}, Y {:+.0f}; reproj "
                      "{:.2f} px, size {:+.0f}%)  skew {:.1f} ms".format(
                          ball.depth_mm, ball.xyz_m[0] * 1000.0,
                          ball.xyz_m[1] * 1000.0, ball.reprojection_px,
                          ball.radius_error * 100.0, skew * 1000.0))
            else:
                print("  NO BALL - {}".format(reason))
                print("  skew {:.1f} ms  -> MOVE THE BALL AND RETAKE".format(
                    skew * 1000.0))

            # "found" is recorded, not just printed. Without it the
            # completeness gate below counts shots that have no ball in them
            # and can green-light a series with, say, four depth entries of
            # which two the analysis will reject outright.
            shots.append({"name": name, "tape_mm": tape_mm, "series": series,
                          "found": both})
            _write_manifest(out_dir, shots)

    return _report_completeness(shots)


def _usable_counts(shots):
    """Per-series counts of shots that actually had a ball in both frames.

    Entries written before "found" was recorded are counted as usable: the
    alternative is declaring an older run empty, and the analysis will
    reject any of them that really are ball-less anyway.
    """
    return {label: sum(1 for s in shots
                       if s.get("series") == label and s.get("found", True))
            for label in sorted(set(SERIES.values()))}


def _report_completeness(shots):
    """Print what the series has and what it still needs; 0 if complete."""
    counts = _usable_counts(shots)
    usable = sum(counts.values())
    print("\n{} shots on disk, {} usable: {}".format(
        len(shots), usable,
        ", ".join("{} {}".format(v, k) for k, v in sorted(counts.items()))))

    short = []
    if counts["target"] < 2:
        short.append("yaw needs 2 usable target-line positions and cannot be "
                     "recovered later from a floor-only series")
    if counts["depth"] < 4:
        # Not "collinear": the fit compares depth differences and does not
        # depend on the line being straight. It is still meant to be one,
        # because an uncontrolled layout is an uncontrolled measurement, and
        # the analysis reports how far off a line the positions actually
        # were.
        short.append("the scale fit needs 4+ usable depth positions, laid "
                     "along one line running away from the unit")
    if counts["spread"] < 2:
        # The gate this replaces was depth + spread >= 3, which six depth
        # shots satisfy on their own - and six depth shots are a LINE. The
        # plane fit then raises, and pitch, roll and yaw are all lost
        # together, after the operator has packed up. Spread is a
        # requirement in its own right for that reason.
        short.append("the floor plane needs 2+ usable spread positions: what "
                     "makes the plane determined is LATERAL spread across the "
                     "image width, not the number of shots. Depth positions "
                     "are collinear by design and fit any plane through their "
                     "line, so a depth-only series loses pitch, roll and yaw "
                     "at once")
    if counts["depth"] + counts["spread"] < 3:
        short.append("the floor plane needs 3+ usable floor positions in total")
    for line in short:
        print("INCOMPLETE: " + line)
    return 1 if short else 0


# The distance the depth tolerance in the rig header is quoted at. The series
# spans roughly 350-700 mm, and the sensitivity goes as Z^2, so no single
# number covers it; 500 mm is the decided working distance and the midpoint of
# the suggested layout, which makes it the useful one to quote.
NOMINAL_WORKING_DISTANCE_M = 0.50


def _measure_shot(rig, run_dir, shot, refine=None):
    """Return (xyz_m, worst_reprojection_px) or (None, reason).

    What belongs here is the file layer: read both frames, refuse a frame at
    the wrong resolution, and turn whatever ball_pair says into one row of
    the table rather than a traceback that takes the rows already computed
    down with it.

    Choosing WHICH circle is the ball is not this function's job and never
    should have been. It needs the rig - a golf ball is 42.67 mm, so only
    the range its own disparity implies can say whether a circle is the
    right size to be one - and it lives in ball_pair, where the capture
    path calls exactly the same code. That is the point: a shot rejected
    here would have been rejected at the device, while the operator could
    still do something about it.
    """
    frames = {}
    for n in (1, 2):
        path = os.path.join(run_dir, "cam{}".format(n), shot["name"])
        frame = cv2.imread(path)
        if frame is None:
            return None, "missing {}".format(path)
        # shape is (rows, cols, ...) so [1::-1] is (width, height), the order
        # rig.image_size uses. calibration_capture asks the driver for the
        # calibrated resolution best-effort and says itself that negotiation
        # can fall back; if it did, every intrinsic is wrong for these frames
        # and nothing downstream would say so.
        size = tuple(frame.shape[1::-1])
        if size != rig.image_size:
            return None, "cam{} is {}x{}, not {}x{}".format(
                n, size[0], size[1], rig.image_size[0], rig.image_size[1])
        frames[n] = frame

    ball, reason = ball_pair.find_ball_pair(rig, frames[1], frames[2],
                                            refine=refine)
    if ball is None:
        return None, reason
    return ball.xyz_m, ball.reprojection_px


def run_analysis(run_dir, extrinsics_path, config_path, refine=None):
    try:
        rig = stereo_geometry.load_rig(extrinsics_path, config_path)
        stereo_geometry.validate_rig(rig)
    except stereo_geometry.StereoRigError as e:
        print("ERROR: {}".format(e))
        return 1
    print("rig: baseline {:.3f} mm, fx {:.1f} / {:.1f}".format(
        rig.baseline_m * 1000.0, rig.k1[0, 0], rig.k2[0, 0]))
    # Which method measured every row below. Two runs analysed with
    # different refiners are not comparable row for row.
    print("  outline refiner: {} (every shot)".format(
        (refine or frame_analysis.refine_ball).__name__))
    # Printed here, above the table, because it is the tolerance the operator
    # needs while reading the deviations in it: one pixel of disparity error
    # is worth this many millimetres of depth, so a triangulated Z within
    # about this of the tape is agreement and not a discrepancy to chase.
    print("  depth tolerance: {:.2f} mm per px of disparity error at {:.0f} mm "
          "(about {:.2f} mm at half-pixel matching)".format(
              triangulate.depth_sensitivity_mm_per_px(
                  rig, NOMINAL_WORKING_DISTANCE_M),
              NOMINAL_WORKING_DISTANCE_M * 1000.0,
              triangulate.depth_sensitivity_mm_per_px(
                  rig, NOMINAL_WORKING_DISTANCE_M) / 2.0))

    shots = _load_manifest(run_dir)

    print("\n{:<12} {:>7} {:>9} {:>9} {:>9} {:>9} {:>7} {:>5}".format(
        "shot", "series", "X mm", "Y mm", "Z mm", "tape mm", "reproj", "use"))
    buckets = {"depth": [], "spread": [], "target": []}
    for shot in shots:
        if shot.get("series") not in buckets:
            print("{:<12} {:>62}".format(
                shot["name"], "unknown series " + repr(shot.get("series"))))
            continue
        xyz, info = _measure_shot(rig, run_dir, shot, refine=refine)
        if xyz is None:
            # info is a rejection reason - distinct text for a missing
            # file, a missed detection, a residual over threshold, and a
            # negative-depth (swap) rejection, so the table shows which of
            # those four happened rather than a single flat "NO".
            print("{:<12} {:>7} {:>54}".format(
                shot["name"], shot["series"], info))
            continue
        print("{:<12} {:>7} {:9.1f} {:9.1f} {:9.1f} {:9.1f} {:7.2f} {:>5}".format(
            shot["name"], shot["series"], xyz[0] * 1000, xyz[1] * 1000,
            xyz[2] * 1000, shot["tape_mm"], info, "yes"))
        buckets[shot["series"]].append((shot, xyz))

    # The plane wants every floor position it can get - spread across the
    # image width is exactly what makes it determined. The scale fit does
    # NOT: it compares differences of triangulated DEPTH against differences
    # of perpendicular tape readings, which is the same quantity on both
    # sides no matter where the ball sat laterally, so a spread position
    # would contribute a tape gap that means nothing. Depth only.
    #
    # That estimator no longer needs the depth positions to be collinear -
    # see the scale section below for why the depth component was chosen
    # over the 3D separation. Lay them along a line anyway: a wandering line
    # means the tape was run along something other than what was intended,
    # and a measurement whose setup was not controlled is worth less than
    # its arithmetic suggests. straightness_rms_m exists to make that
    # visible rather than to make it harmless.
    floor = buckets["depth"] + buckets["spread"]
    if len(floor) < 3:
        print("\nOnly {} usable floor shots; a plane needs 3.".format(len(floor)))
        return 1

    # --- attitude ---------------------------------------------------------
    # This is the deliverable: three physical angles describing how the
    # unit sits against the floor, from geometry that owes nothing to
    # PiTrac and would be identical if PiTrac had never existed. Whether
    # and how it gets written into PiTrac's own constant is a separate,
    # later, and lossy question - kept in its own section below so the two
    # are never confused for one another.
    try:
        plane = ground_plane.fit_plane(np.array([xyz for _, xyz in floor]))
        pitch, roll = ground_plane.attitude_from_plane(plane)
    except ground_plane.PlaneFitError as e:
        # fit_plane's near-collinear message names exactly what to do about
        # it - spread the ball positions across the image width - so it is
        # written for the operator reading this output, and is wasted
        # inside a stack trace instead.
        print("\nERROR: {}".format(e))
        return 1

    yaw = None
    yaw_line = "  yaw    not measured - needs 2 usable target-line shots"
    if len(buckets["target"]) >= 2:
        ordered = sorted(buckets["target"], key=lambda item: item[1][2])
        try:
            yaw = ground_plane.yaw_from_target_line(
                plane, ordered[0][1], ordered[-1][1])
            yaw_line = ("  yaw    {:+.3f} deg   target line to the "
                        "camera's right, positive".format(yaw))
        except ground_plane.PlaneFitError as e:
            yaw_line = "  yaw    could not be measured: {}".format(e)

    print("\nmeasured attitude of the unit")
    print("  pitch  {:+.3f} deg   nose-up positive".format(pitch))
    print("  roll   {:+.3f} deg   right-side-down positive".format(roll))
    print(yaw_line)
    # Pitch and roll are the CAMERA's own rotation; yaw is the TARGET LINE's
    # bearing as the camera sees it. The two senses are opposite, and the
    # header above calls all three "attitude", so say it here rather than
    # leave it to be inferred - and do NOT quietly negate one to match, since
    # which sign the unit's own pan convention wants is unresolved until the
    # hardware run.
    #
    # Only when there is a yaw to qualify. Printed under the "not measured"
    # line it explains the sign of a number that is not there.
    if yaw is not None:
        print("  NOTE the yaw sign is not the same sense as the other two. Pitch")
        print("  and roll describe how the CAMERA is rotated; yaw describes where")
        print("  the TARGET LINE runs as the camera sees it, so it is the")
        print("  NEGATION of the unit's own yaw - a unit yawed to the right sees")
        print("  the line off to its left.")
    print("  from {} floor positions, plane rms {:.2f} mm, conditioning "
          "{:.3f}".format(len(floor), plane.rms_m * 1000.0, plane.conditioning))
    # A direct measurement of the 115 mm mounting height the rest of the
    # project only assumes. The plane runs through ball CENTRES, one radius
    # above the floor, so the radius is added back.
    height_m = ground_plane.camera_height_above_floor_m(plane)
    # "below camera 1", not "below it": the nearest antecedent in the first
    # clause is the floor, and above the FLOOR the figure would be 21.3 mm.
    print("  camera 1 sits {:.1f} mm above the floor (the spec assumes 115); "
          "ball centres are {:.1f} mm below camera 1".format(
              height_m * 1000.0,
              (height_m - ground_plane.GOLF_BALL_RADIUS_M) * 1000.0))

    # --- scale ----------------------------------------------------------
    # The measured side is the DEPTH COMPONENT, xyz_b[2] - xyz_a[2], and not
    # the 3D separation norm(xyz_b - xyz_a). The tape reading is a
    # perpendicular distance to the unit's face, so a difference of two of
    # them is a difference of perpendicular distances - which is what a
    # difference of Z is, and is not what a 3D point-to-point separation is.
    #
    # The two agree only if the depth line is both perfectly straight and
    # exactly perpendicular to the face, and BOTH departures inflate only the
    # measured side: 5 mm of lateral wander on a 70 mm gap adds 0.26%, and a
    # line oblique by 5 deg adds 0.38%. Since a scale above 1 prints a
    # SMALLER implied baseline, both errors push the answer toward 78.28 and
    # away from 78.749 - and the signal being resolved between those two is
    # 0.6%. The obliquity in particular is unconstrained, because the unit's
    # forward axis is exactly what this run has not yet measured.
    #
    # Camera 1's z = 0 plane is not the physical lens plane. That offset used
    # to be cancelled by fitting differences; it is now fitted as the
    # intercept, which cancels it just as completely AND reports it - it is
    # the project's only estimate of where the optical centre sits behind the
    # front face.
    #
    # The fit is a straight line through all the depth positions, not least
    # squares through the origin on consecutive differences. That estimator
    # telescoped, for equally spaced positions, to the two endpoints alone,
    # and it discarded repeated measurements at one position because their
    # tape gap is zero - throwing away the cheapest precision on offer.
    depth_shots = buckets["depth"]
    if len(depth_shots) >= 3:
        depths = [float(xyz[2]) for _, xyz in depth_shots]
        tapes = [shot["tape_mm"] / 1000.0 for shot, _ in depth_shots]
        fit = triangulate.fit_scale_regression(depths, tapes)
        # Shots and positions are counted separately because they are not
        # the same leverage: eighteen shots at six readings has the reach of
        # six, and "over 18 depth positions" alone invites the other reading.
        distinct = len(set(shot["tape_mm"] for shot, _ in depth_shots))
        print("\nscale against tape: {:.4f} +- {:.4f} over {} depth positions "
              "at {} distinct tape readings (residual {:.2f} mm)".format(
                  fit.scale, fit.scale_stderr, fit.n, distinct,
                  fit.rms_m * 1000.0))
        # Quoted with its uncertainty because the whole question is 0.6% wide:
        # 78.28 against 78.749. A bare implied baseline to three decimals
        # reads as settled whatever the scatter behind it was.
        baseline_mm = rig.baseline_m * 1000.0
        print("  implied baseline: {:.3f} +- {:.3f} mm against the file's "
              "{:.3f} mm".format(
                  baseline_mm / fit.scale,
                  baseline_mm * fit.scale_stderr / fit.scale ** 2, baseline_mm))
        print("  lens-plane offset: {:+.1f} mm - the tape's zero sits this far "
              "in FRONT of camera 1's z = 0 plane, so a positive value means "
              "the optical centre is that deep inside the housing".format(
                  fit.offset_m * 1000.0))

        # The stderr above is computed from scatter about the fitted line and
        # therefore assumes scatter is the only error. It is not: a detection
        # bias that grows with depth lands entirely in the slope and leaves
        # the residuals small, so the stderr can be a fraction of the real
        # error. This is the number that bounds the random part honestly.
        repeat_spread = triangulate.pooled_repeat_spread_m(depths, tapes)
        if repeat_spread is None:
            print("  repeat spread: not measured - no tape reading was "
                  "captured twice, so nothing independent bounds the stderr "
                  "above. Three shots per position, RE-PLACING the ball each "
                  "time, costs two keypresses and measures it.")
        else:
            repeated = sum(1 for tape in set(tapes) if tapes.count(tape) > 1)
            print("  repeat spread: {:.2f} mm rms at repeated positions "
                  "({} of {} tape readings repeated). Repeats taken without "
                  "re-placing the ball share the same sub-pixel phase and "
                  "understate this; a bias that grows with Z is a scale error "
                  "by another name and no repeat can see it.".format(
                      repeat_spread * 1000.0, repeated, distinct))

        line = triangulate.fit_line(np.array([xyz for _, xyz in depth_shots]))
        # A crooked line no longer biases the scale - the fit uses Z alone -
        # but it still means the tape was run along something other than
        # what was intended. Reported so it is visible rather than silent.
        print("  depth line straightness: {:.1f} mm rms off its own best-fit "
              "line (scale uses Z alone, so this does not bias it)".format(
                  line.rms_m * 1000.0))
        # The one thing the run had no measurement of at all. Comparing a
        # difference of Z against a difference of tape readings assumes the
        # line the balls sat on ran along the optical axis; the angle between
        # them multiplies the measured side by its cosine. 2 deg is 0.06%,
        # 5 deg is 0.38%, against a 0.6% signal.
        print("  depth line obliquity: {:.2f} deg off the optical axis "
              "(horizontal {:+.2f}, vertical {:+.2f} deg). Vertical should "
              "echo the pitch above for a level floor line.".format(
                  line.obliquity_deg, line.horizontal_deg, line.vertical_deg))
        # cos(obliquity) IS direction[2] - taking it from the vector rather
        # than re-cosining the printed, rounded angle.
        cos_obliquity = float(line.direction[2])
        if cos_obliquity > 0.7:
            print("  scale if the tape ran along that line: {:.4f} +- {:.4f} "
                  "(raw / cos obliquity). Use THIS one if the readings came "
                  "off a rule the balls sat on; use the raw one if they were "
                  "perpendicular distances to the front face. The two agree "
                  "to {:.2f}% here.".format(
                      fit.scale / cos_obliquity,
                      fit.scale_stderr / cos_obliquity,
                      100.0 * (1.0 / cos_obliquity - 1.0)))
        else:
            print("  the depth line is {:.1f} deg off the optical axis - too "
                  "far for either reading of the tape to mean much. Re-lay it "
                  "roughly straight out from the unit.".format(
                      line.obliquity_deg))
    else:
        print("\nscale: needs 3+ usable depth positions laid along one line "
              "running away from the unit, have {}".format(len(depth_shots)))

    # --- writing this into PiTrac's legacy constant, explicitly a lossy
    # inheritance and not the measurement itself ---------------------------
    offset = stereo_geometry.camera2_offset_from_camera1(rig)
    print("\nwriting this into PiTrac's kCameraNAngles")
    print("  A two-element [pan, tilt] from PiTrac, whose cameras are")
    print("  individually aimed and whose roll is zero by construction.")
    print("  Ours is a three-axis residual of a bolted plate, so the")
    print("  mapping drops one of the three.")
    print()
    print('  "kCamera2OffsetFromCamera1OriginMeters": '
          "[{:.6f}, {:.6f}, {:.6f}]".format(*offset))
    # An unmeasured pan is printed as a placeholder, never as 0.000. Twenty
    # lines below, roll is called "DROPPED, not zero"; printing a fabricated
    # zero for pan here - in a line shaped to be copied straight into the
    # config - would hold pan to a lower standard than roll, and it is the
    # copyable line that does the damage.
    if yaw is None:
        print('  "kCamera1Angles": [ ????, {:+.3f}]   (pan, tilt) - pan NOT '
              "MEASURED, do not paste a zero".format(pitch))
    else:
        print('  "kCamera1Angles": [{:+.3f}, {:+.3f}]   (pan, tilt)'.format(
            yaw, pitch))
    print("  kCamera2Angles is deliberately NOT printed. Camera 2 is rotated "
          "relative to camera 1 by the extrinsics' R - about a degree on this "
          "rig - so its pan and tilt are NOT the numbers above, and copying "
          "these into both lands that degree straight in HLA and VLA. "
          "Deriving camera 2's own angles needs the attitude composed with R, "
          "which is Block 2's full-rotation job, not this constant's.")
    print()
    # Tilt's sign is anchored, not guessed: PiTrac ships kCamera1Angles =
    # [18.72, -24.18] for a camera physically tilted DOWN toward the tee,
    # and docs/camera/camera-calibration.md:171 says "Y/tilt is negative as
    # the camera starts to face down" - exactly attitude_from_plane's
    # convention (negative pitch for nose-down). Do not re-derive this.
    print("  tilt = pitch.  {:+.3f} deg. Sign anchored: PiTrac ships "
          "kCamera1Angles = [18.72, -24.18] for a camera tilted DOWN toward "
          "the tee, and docs/camera/camera-calibration.md:171 says \"Y/tilt "
          "is negative as the camera starts to face down\" - matching "
          "attitude_from_plane's convention (negative pitch for "
          "nose-down).".format(pitch))
    if yaw is None:
        print("  pan  = yaw.    not measured - needs 2 usable target-line "
              "shots.")
    else:
        # Pan has NO such anchor. yaw_from_target_line's convention is
        # "positive means the target line runs to the camera's right";
        # PiTrac's pan is the camera's own twist, positive counter-
        # clockwise viewed from above - plausibly the opposite sign, or not
        # even the same quantity. A wrong sign here lands 1:1 in horizontal
        # launch angle, silently, so this is not printed as settled.
        print("  pan  = yaw.    {:+.3f} deg. SIGN UNVERIFIED. This is the "
              "angle from the camera's forward axis to the target line, "
              "positive meaning the target line runs to the camera's "
              "right (yaw_from_target_line's convention). Whether that "
              "matches PiTrac's own pan convention - positive "
              "counter-clockwise viewed from above - has not been checked. "
              "Confirm against the physical target-line placement when "
              "this capture run is actually done.".format(yaw))
        # Pitch and roll are pinned by the mount and the floor and are
        # properties of the device. Yaw is the angle to a line the operator
        # chose, and the unit is free-standing - no mat edge, no marked
        # position - so it describes the session. Pasting it into a constant
        # freezes one afternoon's placement into the geometry.
        print("  Beyond its sign: with the unit free-standing this angle "
              "describes TODAY'S PLACEMENT and not the unit. Pitch and roll "
              "are pinned by the mount and the floor; yaw is pinned by where "
              "the unit was set down. It becomes a constant only once that "
              "placement is repeatable - a mat edge or a marked position.")
    print("  roll = {:+.3f} deg is DROPPED, not zero: kCamera1Angles "
          "carries no roll term to hold it.".format(roll))
    print("\nBlock 2 should carry the attitude as a full rotation applied "
          "to triangulated points rather than as two Euler angles in this "
          "constant, since the constant cannot hold what we measure.")
    return 0


def main(argv=None):
    parser = argparse.ArgumentParser(description=__doc__,
                                     formatter_class=argparse.RawDescriptionHelpFormatter)
    parser.add_argument("--shots", type=int, metavar="N",
                        help="capture N ball positions, prompting for each")
    parser.add_argument("--out", default="sp1_vision/triangulation_run",
                        help="run directory for --shots (default: %(default)s)")
    parser.add_argument("--exposure", type=int, metavar="N",
                        help="manual exposure in 100 us units (1-5000); "
                             "omit for auto")
    parser.add_argument("--analyse", metavar="RUNDIR",
                        help="analyse a captured run directory")
    parser.add_argument("--extrinsics",
                        default=stereo_geometry.DEFAULT_EXTRINSICS_PATH,
                        metavar="PATH",
                        help="stereo_extrinsics.json: R and T from the "
                             "calibration solve (default: %(default)s). Must "
                             "come from the SAME solve as --config; the two "
                             "are only self-consistent together")
    parser.add_argument("--config", default=stereo_geometry.DEFAULT_CONFIG_PATH,
                        metavar="PATH",
                        help="golf_sim_config.json: the camera matrices and "
                             "distortion vectors (default: %(default)s). Read "
                             "only - this tool never writes to it")
    parser.add_argument("--refiner", choices=sorted(REFINERS),
                        default="canny",
                        help="outline refiner for --analyse, applied to "
                             "EVERY shot (default: %(default)s, the one "
                             "capture uses). 'contrast' is for scenes whose "
                             "surround is bright, where canny loses far "
                             "balls; never mix the two within a run")
    args = parser.parse_args(argv)

    if args.analyse and args.shots:
        parser.error("--analyse and --shots do different things; pick one")
    if args.shots:
        return run_shots(args.shots, args.out, args.exposure,
                         args.extrinsics, args.config)
    if args.analyse:
        return run_analysis(args.analyse, args.extrinsics, args.config,
                            refine=REFINERS[args.refiner])
    parser.error("give either --shots N or --analyse RUNDIR")


if __name__ == "__main__":
    sys.exit(main())
