Pilzkoma/PiTrac/Software/LMSourceCode/ImageProcessing/v4l2_interface.cpp

/*****************************************************************//**
 * \file   v4l2_interface.cpp
 * \brief  Jetson replacement for libcamera_interface.cpp.
 *         Contains stub implementations of functions that are
 *         no-ops or deferred on the initial Jetson build.
 *         Group 2 runtime implementations will be added here once
 *         cameras arrive and the first meson configure is clean.
 *
 * \author JetsonLM port
 * \date   2026-03-16
 *********************************************************************/

/* SPDX-License-Identifier: GPL-2.0-only */
/*
 * Copyright (C) 2022-2025, Verdant Consultants, LLC.
 */

#ifdef JETSON_BUILD  // JETSON_STUB: Jetson-only — excluded on RPi build

#ifdef __unix__  // Ignore in Windows environment

#include "v4l2_interface.h"
#include "motion_detect.h"
#include "gs_config.h"
#include "logging_tools.h"
#include "pulse_strobe.h"
#include "golf_ball.h"
#include "gs_camera.h"
#include "camera_hardware.h"
#include "gs_options.h"
#include "ball_watcher.h"

#include <fcntl.h>
#include <unistd.h>
#include <sys/ioctl.h>
#include <sys/mman.h>
#include <linux/videodev2.h>
#include <turbojpeg.h>

#include <cerrno>
#include <cstring>
#include <chrono>

#include <opencv2/calib3d.hpp>
#include <opencv2/imgproc.hpp>
#include <opencv2/videoio.hpp>


// ---------------------------------------------------------------------------
// V4L2Capture skeleton — full bodies land in subsequent commits.
// Skeleton bodies make the class linkable so the build stays green.
// Lives in the global namespace, matching the JetsonCaptureApp struct
// declared in v4l2_interface.h.
// ---------------------------------------------------------------------------

V4L2Capture::V4L2Capture() {
    fourcc_ = V4L2_PIX_FMT_MJPEG;
}

V4L2Capture::~V4L2Capture() {
    release();
}
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
