Pilzkoma/PiTrac/(commit log)

2026-03-16 Add CLAUDE.md — Jetson porting context for Claude Code
2026-03-16 Add PORTING_TASKS.md — full Jetson porting checklist
2026-03-16 meson: add jetson_build option, guard libcamera/lgpio/rpicam-apps, fix OpenCV floor to 4.5.0, fix neon undefined variable
2026-03-16 SP1 port: guard libcamera_interface.h with JETSON_BUILD, create v4l2_interface.h with JetsonCaptureApp
2026-03-16 SP1 port: guard still_image_libcamera_app.hpp, update ball_watcher.h for Jetson signature
2026-03-16 SP1 port: add JetsonCompletedRequest to v4l2_interface.h, rewrite ball_watcher_event_loop for Jetson
2026-03-16 SP1 port: complete Group 1 — motion_detect.h stub base class, motion_detect_stage.cpp Jetson guards
2026-03-16 SP1 port: complete Group 3 stubs — v4l2_interface.cpp created, libcamera_interface.cpp guarded, all 24 porting tasks done
2026-03-16 LOGBOOK: SP1 to 55%, Group 3 complete, ready for Jetson first configure
2026-03-16 SP1 port: lower boost version floor to >=1.71.0 for JetPack 5.1.6
    Ubuntu 20.04 (JetPack 5.1.6) ships Boost 1.71 — 1.74.0 floor would
    require a manual Boost build on Jetson.
2026-03-16 SP1 port: add -DJETSON_BUILD preprocessor define to meson.build
    Without this, all #ifdef JETSON_BUILD guards in the ported source files
    are never triggered even when building with -Djetson_build=true.
2026-03-16 SP1 port: fix Boost 1.71/C++20 allocator error, guard libcamera include in gs_fsm and lm_main
    - Add -DBOOST_NO_CXX11_ALLOCATOR: workaround for Boost 1.71 named_scope.hpp
    incompatibility with C++20 (allocator::reference removed)
    - gs_fsm.cpp, lm_main.cpp: swap bare libcamera_interface.h include for
    #ifndef JETSON_BUILD / v4l2_interface.h pattern, matching ball_watcher.h
    [gs_fsm.cpp, lm_main.cpp]
2026-03-16 LOGBOOK: SP1 session 3 — first Jetson compile, Boost 1.74 build in progress
2026-03-18 SP1 port: fix 3 remaining compile errors for Jetson build
    - libcamera_jpeg.cpp: wrap entire file in #ifndef JETSON_BUILD; file is
    RPi/libcamera-specific and has no Jetson equivalent
    - v4l2_interface.h: move SetLibCameraLoggingOff() into LibCameraInterface
    class body so LibCameraInterface::SetLibCameraLoggingOff() in .cpp resolves
    - gs_fsm.cpp: add explicit deduction guide for overload<> helper struct;
    GCC 10 does not support CTAD for aggregates without an explicit guide
    [gs_fsm.cpp, libcamera_jpeg.cpp, v4l2_interface.h]
2026-03-18 SP1 port: guard pulse_strobe.cpp with #ifndef JETSON_BUILD
    Entire file uses lgpio GPIO and SPI APIs which do not exist on Jetson.
    Group 2 Jetson replacement (libgpiod + Linux SPI ioctl) pending.
    [pulse_strobe.cpp]
2026-03-18 SP1 port: swap libcamera_interface.h → v4l2_interface.h in 3 more files
    gs_camera.cpp, gs_config.cpp, gs_calibration.cpp all included
    libcamera_interface.h without a JETSON_BUILD guard. Apply the same
    #ifndef JETSON_BUILD / #else / #include "v4l2_interface.h" / #endif
    pattern already in place in gs_fsm.cpp and lm_main.cpp.
    [gs_calibration.cpp, gs_camera.cpp, gs_config.cpp]
2026-03-18 SP1 port: guard libcamera/camera.h include in camera_hardware.cpp
    Only the single #include <libcamera/camera.h> is RPi-specific; the rest
    of the file (init_camera_parameters, calibration matrices, test-frame
    machinery) is platform-independent and must compile on Jetson.
2026-03-18 SP1 port: add missing #include <thread> to gs_ipc_system.cpp
    std::this_thread::yield() requires <thread>; the include was absent.
    [gs_ipc_system.cpp]
2026-03-18 SP1 port: add static member defs and stub functions to v4l2_interface.cpp
    Static member definitions (Part 1):
    - All LibCameraInterface static data members copied from
    libcamera_interface.cpp with identical default values
    - libcamera_app_[] type changed to JetsonCaptureApp* (Jetson replacement
    for LibcameraJpegApp*)
    - kCroppedImagePixelOffsetLeft/Up promoted from free namespace vars to
    LibCameraInterface:: class member definitions to match v4l2_interface.h
    Stub function definitions (Part 2):
    - PulseStrobe::InitGPIOSystem/DeinitGPIOSystem/SendCameraPrimingPulses/
    SendExternalTrigger/GetPulseIntervals — pulse_strobe.cpp is entirely
    guarded by #ifndef JETSON_BUILD; these satisfy the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
    [v4l2_interface.cpp]
2026-03-18 SP1 port: add program_options_dep and motion_detect_stage.cpp to meson.build
    - Add boost program_options as a separate dependency and include it in
    pitrac_lm_module_deps; boost_dep only pulls timer/log/thread/filesystem/regex
    - Add post_processing_stages/motion_detect_stage.cpp directly to
    pitrac_lm_sources under jetson_build guard; the post_processing_stages/
    subdir() call is skipped on Jetson so the file would otherwise not compile
2026-03-18 SP1 port: fix motion_detect_stage.cpp std::clamp type mismatch and LOG macro on Jetson
    - Wrap std::clamp calls (lines 158-161) with JETSON_BUILD guard; cast
    info.width/height to uint on Jetson side (local struct uses int, RPi
    StreamInfo uses uint — std::clamp requires uniform type)
    - Replace LOG(1, ...) at two call sites with GS_LOG_MSG(trace, ...)
    under JETSON_BUILD; LOG macro comes from rpicam-apps post-processing
    framework which does not exist on Jetson
2026-03-19 SP1 port: exclude E6/TruGolf closed-source machinery from Jetson build
    Jetson targets GSPro only; E6 integration is not needed.
    Guard three sections with if not jetson_build:
    - closed_source_target custom_target + cp/source blocks for
    gs_e6_response.cpp.o (closed-source pre-compiled object)
    - gs_e6_interface.cpp and gs_e6_results.cpp moved out of unconditional
    sources list into else branch of the jetson_build conditional
    - post_build1/post_build2 custom_targets that copy gs_e6_response.cpp.o
    back out of the build directory
2026-03-19 SP1 port: guard GsE6Interface call sites with #ifndef JETSON_BUILD
    lm_main.cpp:772 and gs_sim_interface.cpp:66-82 referenced GsE6Interface
    after it was excluded from the Jetson build. Wrapped those blocks so only
    the unconditional sleep(5) remains active on Jetson.
2026-03-19 LOGBOOK: SP1 first successful build milestone — pitrac_lm running on Jetson
2026-03-21 LOGBOOK: SP4 first successful end-to-end test — OpenShotGolf integration milestone
    SP4 promoted from Planning/Design to In Progress/Build at 10%.
    First end-to-end test passed: Jetson → TCP/49152 → OpenShotGolf → 3D ball flight.
    Decisions, tests, next steps, session notes, known issues, env guide, and tool stack all updated.
2026-03-21 LOGBOOK: SP4 full session update — complete software stack built end-to-end
    SP4 to 35%. Full stack: TCP sender, OpenShotGolf integration, SQLite DB,
    Flask dashboard (4 tabs, player filtering, Chart.js dispersion), Unix socket
    interface (shot_receiver.py + test_client.py + shot_sender.h C++ header).
    Architecture proven: C++ → Unix socket → Python → TCP → simulator + DB → dashboard.
2026-03-21 LOGBOOK: SP1 camera_test.py + SP4 V3 standalone simulator vision
    - SP1 Decisions Log: V3 long-term goal row (Jetson renders OpenShotGolf via HDMI)
    - SP1 Next Steps: 5 camera_test.py items prepended (OV9281 arrival checklist)
    - SP1 Session Notes: 2026-03-21 entry for camera_test.py creation
    - Environment Setup Guide: items 19–20 (camera_test.py, v4l-utils)
    - SP4 Design Notes: V3 Vision standalone simulator section
2026-04-26 SP1: dual-camera 120 FPS sustained capture test
    Validates that both OV9281 USB3 cameras can sustain 1280x800 MJPG @ 120 FPS
    in parallel — sanity check before implementing real V4L2 capture in
    v4l2_interface.cpp. Cameras are on separate USB buses (xhci-2.2.4 and
    xhci-2.3) so no shared-bandwidth conflict is expected.
2026-04-26 SP1: add --exposure flag to dual_camera_test for manual-exposure validation
    Auto-exposure caps frame rate when integration time exceeds frame interval
    (measured 55 FPS at exposure_absolute=157 = 15.7ms in normal indoor light,
    matches the 1000/15.7 ≈ 64 FPS theoretical ceiling). The real pipeline
    uses a sub-millisecond IR strobe as the effective shutter, so 120 FPS will
    only be reachable with manual exposure pinned to a tiny value. Sets
    exposure via v4l2-ctl subprocess (more reliable than OpenCV's wrapper)
    and restores auto-exposure on exit.
2026-04-26 LOGBOOK: SP1 dual-camera 120 FPS verified, OpenCV decode bottleneck diagnosed
    v4l2-ctl raw streaming sustains 120 FPS @ 1280x800 MJPG on both OV9281
    cameras simultaneously — kernel/USB/camera path is production-ready.
    OpenCV cv2.VideoCapture caps Python at ~60 FPS due to CPU-bound MJPG
    decode in cap.read(); not a blocker since the C++ port will use V4L2
    ioctl directly with libjpeg-turbo or nvJPEG. Issues #15 and #16 added.
    SP1 next: implement the 5 stub functions in v4l2_interface.cpp.
2026-04-29 LOGBOOK: add OpenFlight as V2 radar reference, expand hardware registry
    OpenFlight (github.com/jewbetcha/openflight) is the most relevant open-source
    DIY launch monitor for V2 radar planning — validates OPS243-A 24 GHz Doppler
    for golf ball speed (±0.5%), K-LD7 for launch angle, and SEN-14262 sound
    trigger as a cheap impact detector. Added as primary V2 reference, with
    explicit AGPL-vs-GPL-3 license caveat (re-implement clean-room rather than
    port code). Hardware Components Registry expanded with three new candidate
    components: SEN-14262 (optional V1 backup trigger), OPS243-A (V2 radar),
    K-LD7 (V2 stretch). Issue #5 updated to note V2 sensor choice is now open
    between LiDAR and radar. New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
2026-04-29 SP1: add libturbojpeg dependency for V4L2 capture engine
    Group 2 task. Adds libturbojpeg (apt: libturbojpeg0-dev) under the
    jetson_build guard. Resolves via pkg-config first, falls back to
    cxx.find_library('turbojpeg'). Used by V4L2Capture for MJPG decode
    in the upcoming v4l2_interface.cpp implementation.
2026-04-29 SP1: V4L2Capture skeleton, swap JetsonCaptureApp::cap type
    Adds V4L2Capture class declaration to v4l2_interface.h with the six
    public methods that mirror cv::VideoCapture (open/isOpened/release/
    read/set/get) plus the two private helpers (ensure_streaming,
    decode_into). All bodies are stubs in this commit; implementations
    land task-by-task.
    Swaps JetsonCaptureApp::cap from cv::VideoCapture to V4L2Capture.
    ball_watcher.cpp continues to compile unchanged because the public
    method names match.
    [v4l2_interface.cpp, v4l2_interface.h]
2026-04-29 SP1: V4L2Capture::open and release
    open() acquires the V4L2 fd and verifies the device advertises
    V4L2_CAP_VIDEO_CAPTURE. No format / buffer / streaming setup yet
    — that's lazy on first read().
    release() unwinds whatever was set up: STREAMOFF if streaming, munmap
    any mapped buffers, tjDestroy the decoder handle, close the fd.
    Tolerant of partial state so it can run from the destructor.
    Adds <cerrno> and <cstring> for errno/strerror in error messages.
    [v4l2_interface.cpp]
2026-04-29 SP1: V4L2Capture::set and get
    set() handles cv::CAP_PROP_FRAME_WIDTH/HEIGHT/FOURCC/FPS as cached
    state (only valid before first read() / stream-on), and
    CAP_PROP_EXPOSURE/GAIN as V4L2 controls — applied immediately if
    streaming, queued in pending_ctrls_ otherwise.
    EXPOSURE input is microseconds (matches PiTrac's
    kCameraN*StillShutterTimeuS statics); converted to V4L2_CID_EXPOSURE_
    ABSOLUTE's 100µs units internally.
    FOURCC accepts only V4L2_PIX_FMT_MJPEG — purpose-built engine.
    get() returns cached values for format props; CAP_PROP_FPS does a
    VIDIOC_G_PARM round-trip when the device is open so callers see the
    rate the driver actually settled on.
    Pulls <opencv2/videoio.hpp> into the .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
2026-04-29 SP1: V4L2Capture lazy stream-on + read with libjpeg-turbo decode
    ensure_streaming() applies the cached format / FPS / pending V4L2
    controls and walks the standard V4L2 mmap setup: REQBUFS=4 →
    QUERYBUF + mmap each → QBUF all → STREAMON. Allocates the gray_scratch_
    mat (CV_8UC1, height_ × width_) and the libjpeg-turbo decompressor
    handle.
    read() blocks on VIDIOC_DQBUF, hands the JPEG payload to decode_into(),
    re-queues the buffer with VIDIOC_QBUF (regardless of decode result so
    the camera doesn't stall).
    decode_into() does tjDecompress2 with TJPF_GRAY into gray_scratch_,
    then cv::cvtColor → CV_8UC3 BGR. Drop-in compatible with what
    cv::VideoCapture::read() returned previously.
    Th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
    [v4l2_interface.cpp]
2026-04-29 SP1: PerformCameraSystemStartup — probe OV9281 cameras, allocate apps
    Real implementation of the first of four camera-stub replacements.
    Probes /dev/video0 and /dev/video2 (the OV9281 device mapping
    confirmed in LOGBOOK 2026-03-21), VIDIOC_QUERYCAP-checks each, and
    allocates a JetsonCaptureApp per slot into LibCameraInterface::
    libcamera_app_[0/1]. Per-camera defaults (gain, contrast, saturation,
    shutter_time_us) come from the existing kCameraN* statics.
    Marks libcamera_configuration_[] = kHighSpeedWatching for cam1,
    kExternallyStrobed for cam2 — matching the RPi pipeline's intent.
    Idempotent: deletes any previously allocated app before re-allocating,
    so re-init from a soft restart is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
    [v4l2_interface.cpp]
2026-04-29 SP1: TakeRawPicture — real V4L2 still capture via JetsonCaptureApp
    Routes to V4L2Capture::open + set + read on the per-slot
    JetsonCaptureApp. Lazily opens the device on first call, applies
    format / FPS / exposure / gain from the app's per-camera config,
    then read()s a single frame. Subsequent calls reuse the open
    device — first call pays the lazy stream-on cost (~30-50 ms);
    repeated calls are at the per-frame budget.
    No undistort_camera_image call — that helper is still in the
    RPi-guarded libcamera_interface.cpp. Returning the raw frame for
    v1; undistort port is a follow-up.
2026-04-29 SP1: CheckForBall — legacy detection body via real V4L2 capture
    Body adapted from CheckForBallLegacy in libcamera_interface.cpp:1366,
    which is RPi-build-only (the whole file is #ifndef JETSON_BUILD-
    guarded). Duplicated rather than reused since the user's brief
    limits us to v4l2_interface.{h,cpp} + meson.build.
    Touches only hardware-independent helpers (GolfSimCamera::
    init_camera_parameters / GetExpectedBallCenter / GetCalibratedBall).
    The YOLO/ONNX path (CheckForBallEnhanced) is intentionally left out
    — legacy detector is enough for v1, YOLO can land later.
    Drops the firstCannedImageFileName line from the original (RPi-
    development fixture path under /mnt/VerdantShare).
    Co-Authored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
    [v4l2_interface.cpp]
2026-04-29 SP1: WatchForHitAndTrigger — route to ball_watcher_event_loop (motion-only)
    Replaces the stub with a thin call into the existing
    ball_watcher_event_loop(JetsonCaptureApp&, bool&), already wired
    to V4L2Capture via JetsonCaptureApp::cap. The IPC trigger to
    camera 2 inside PulseStrobe::SendExternalTrigger() remains a stub
    — this commit handles the motion-detect half only. Strobe-SPI
    work is a separate Group 2 task once the IR LED hardware lands.
    Camera 1 must be initialised by PerformCameraSystemStartup before
    this is called; explicit error if not.
    [v4l2_interface.cpp]
2026-04-29 SP1: flip PulseStrobe stubs to return true (FSM unblocker)
    Previously the four PulseStrobe::* stubs returned false, which the
    FSM init chain (gs_fsm.cpp:959, lm_main.cpp:1159) treated as fatal
    and aborted before reaching camera capture.
    Flipped to return true so the FSM advances. Real libgpiod / SPI
    work is a separate Group 2 task (IR LED array not ordered, strobe
    SPI not implemented). SendExternalTrigger is genuinely a no-op
    until that lands.
    This unblocks Task 10 end-to-end smoke verification.
    [v4l2_interface.cpp]
2026-04-29 SP1: V4L2Capture FPS instrumentation per read()
    Per-instance frame counter + steady_clock start point. Every 120
    successful read() calls logs a trace line with frame number, elapsed
    seconds, and average FPS since the first frame.
    Lets us prove sustained 120 FPS from the new V4L2 capture engine
    directly — independent of any downstream consumer's resolution
    checks or motion-detect pipeline.
2026-04-29 SP1: PerformCameraSystemStartup sets resolution override 1280x800
    The OV9281 sensor is 1280x800 native, but PiTrac's CameraHardware
    layer defaults to 1456x1088 for the PiGS CameraModel. The check at
    camera_hardware.cpp:205 ('Returned photo does not match camera
    resolution!') was rejecting every frame our V4L2 engine returned.
    Setting CameraHardware::resolution_x_override_ / resolution_y_override_
    in PerformCameraSystemStartup is the same mechanism gs_automated_
    testing.cpp and lm_main.cpp already use for non-default resolutions —
    just calling the existing override before any GolfSimCamera.init_
    camera_parameters() runs.
    This unblocks the FSM advancing past the WaitingForBall retry loop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
2026-04-29 SP1: diagnostic logs for ball_watcher silent stall
    After the resolution override unblocked CheckForBall, the FSM advances
    through WaitingForBallStabilization x6 to WaitingForBallHit, but then
    goes silent — no further log output, no FPS lines, but the process
    keeps running.
    Adding entry/calling/returned trace lines to WatchForHitAndTrigger and
    entry/success lines to V4L2Capture::open so we can pinpoint whether
    the hang is before/inside/after ball_watcher_event_loop, and whether
    the device reopen succeeds.
    [v4l2_interface.cpp]
2026-04-29 SP1: tighten FPS log to every 10 frames, reset per-stream
    The ball_watcher_event_loop exits on first motion-detect tripping,
    which can happen within ~1 second after open/release recycling the
    device. At 120 FPS that is ~120 reads — right at the prior log
    threshold.
    Drop the threshold to every 10 frames so even short loops give data,
    and reset frame_count_ + fps_log_start_ inside ensure_streaming so
    each streaming session reports its own rate (not accumulated across
    the WaitingForBallStabilization phase that precedes
    WatchForHitAndTrigger).
    [v4l2_interface.cpp]
2026-04-29 SP1: log every frame for first 5, then every 10 — see short bursts
    Previous threshold of every 10 was missing the very short
    ball_watcher_event_loop runs that exit on first motion-detect
    (<10 frames). Log every frame for 1..5, then every 10, so we get
    data from both short bursts and long loops.
    Also log decoded= flag so we can tell DQBUF/QBUF success apart from
    decode success.
    [v4l2_interface.cpp]
2026-04-29 LOGBOOK: SP1 V4L2 capture engine landed, ~127 FPS sustained
    Marks the SP1 milestone. V4L2Capture engine replaces cv::VideoCapture
    inside JetsonCaptureApp and sustains 125-130 FPS in the
    ball_watcher_event_loop tight read path on the Jetson Xavier NX with
    real OV9281 cameras connected. CheckForBall path is FSM-overhead bound
    at ~8 FPS, not engine-bound.
    Logbook updates:
    * Master Overview: SP1 to 85% complete, last updated 2026-04-29.
    * Decisions Log: 4 new entries (engine architecture; resolution
    override; PulseStrobe stubs flipped; ActiveMQ broker setup).
    * Tests table: 2026-04-29 entry with measured per-frame intervals.
    * Session Notes: full architecture summary + 5 known follow-ups
    (u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
2026-05-02 SP1: wire ConfigurePostProcessing on Jetson watch path + warm-up frames
    WatchForHitAndTrigger now calls ConfigurePostProcessing with a full-frame
    ROI before ball_watcher_event_loop, so MotionDetectStage::Read() picks up
    incoming_configuration instead of falling through to the cpp defaults
    (roi 1x1, region_threshold=0) that tripped on the first comparison frame.
    ball_watcher_event_loop also discards 2 warm-up frames after stream-on so
    the first decoded frame's pre-AGC content can't bias previous_frame_.
2026-05-02 SP1: port undistort_camera_image + wire into TakeRawPicture
    Body lifted verbatim from libcamera_interface.cpp:950 (pure OpenCV) and
    called from TakeRawPicture so Jetson behavior matches the RPi path —
    downstream ball-detect / stereo geometry sees rectified frames once a
    calibration matrix is loaded. No-op until then.
2026-05-02 SP1: include opencv2/calib3d.hpp for initUndistortRectifyMap
    Compile fix for the undistort_camera_image port — the RPi side picked
    this up transitively, but v4l2_interface.cpp only pulled imgproc/videoio.
    [v4l2_interface.cpp]
2026-05-02 SP1: diagnostic log of regions vs threshold in MotionDetectStage
    Temporary trace (JETSON_BUILD only, every 30th frame) so we can see how
    close we get to region_threshold_ on the bench when motion-detect doesn't
    trip. Will be removed once motion-detect tuning is settled.
2026-05-02 SP1: tune motion_detect_stage thresholds for bench (no-strobe) testing
    kDifferenceM 0.9 -> 0.3 (per-pixel diff threshold was so strict almost no
    pixel changes counted), kDifferenceC 3.0 -> 5.0 (small noise offset),
    kFramePeriod 0 -> 5 (compare frames 42ms apart instead of 8ms — gives
    visible motion enough delta between samples to register).
    Diagnostic confirmed regions=0 across 1200+ frames at the old settings
    even with the lens fully covered. Closer to assets/motion_detect.json
    RPi-tested defaults but with slack since we have no IR strobe yet.
2026-05-02 LOGBOOK + cleanup: SP1 motion-detect tuning landed end-to-end
    Removes the temporary regions/threshold diagnostic log from
    MotionDetectStage::Process — tuning is settled (static scene 0-19
    regions vs threshold 12800; hand-wave trip in <30 frames).
    LOGBOOK additions: 5 new Decisions Log rows (ConfigurePostProcessing
    wireup, warm-up frames, undistort port, calib3d include, threshold
    tune), 2 new Tests rows (static-scene baseline + hand-wave trip),
    2 new Known Issues (#17 ensure_streaming fd leak, #18 motion-detect
    hskip-bytes-vs-pixels), updated SP1 Next Steps, full 2026-05-02
    session note, Setup Guide entries 31-34. SP1 progress 85% -> 88%.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
2026-05-02 SP1 Phase A: Teensy 4.0 strobe controller firmware
    Initial firmware for the Teensy 4.0 IR strobe controller (SP1 Group 2).
    Pulse-train timing offloaded from Jetson to Teensy hardware-timer
    delayMicroseconds for sub-microsecond pulse precision — Jetson sends
    setup once via USB serial, then a single GPIO pulse on FIRE_PIN
    triggers the configured train.
    Pin map: FIRE_PIN=2 (input from Jetson GPIO, RISING edge),
    LED_GATE=3 (output to MOSFET gate), STATUS_LED=13 (onboard LED:
    slow blink = waiting for setup, solid = ready).
    Text protocol over USB serial: PULSES_FAST,3.5,2.8,2.1,1.5,0 etc.
    plus ON_BITS, BAUD, MODE, READY?, STATUS, TEST_FIRE.
    Bench-testable without Jetson via TEST_FIRE in Ardui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
2026-05-02 SP1 Phase B: real PulseStrobe Jetson impl via Teensy + libgpiod
    New file pulse_strobe_jetson.cpp owns the Jetson-side PulseStrobe symbols
    (InitGPIOSystem, DeinitGPIOSystem, SendCameraPrimingPulses,
    SendExternalTrigger, GetPulseIntervals) plus all static member defs.
    The file replaces the no-op stubs in v4l2_interface.cpp.
    InitGPIOSystem opens /dev/ttyACM0 (configurable), claims a single GPIO
    line on gpiochip0 via libgpiod (offset 148 default — verify per carrier
    with `sudo gpioinfo`), and pushes the pulse vectors + on-bits + baud to
    the Teensy via the text protocol from Phase A. Soft fallback on every
    HW failure: warn + continue + SendExternalTrigger no-ops, so dev runs
    still work withou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
    [pulse_strobe_jetson.cpp, v4l2_interface.cpp]
2026-05-02 SP1: fix protected-member access in pulse_strobe_jetson.cpp
    The anonymous-namespace helper send_setup_to_teensy can't reach
    PulseStrobe::pulse_intervals_*_ms_ etc. (protected). InitGPIOSystem is
    itself a static member and has access; pass the values through as
    parameters.
    [pulse_strobe_jetson.cpp]
2026-05-02 SP1: switch fire GPIO default to gpiochip2 line 14 (PCC.02)
    gpiochip0 is the PMIC (only 8 lines, all PMIC-related), gpiochip1's lines
    are all configured as inputs by default, gpiochip2 is the AON Tegra GPIO
    bank with PCC.02 confirmed unused + already configured as output. Pre-
    configured output means no mode change needed when claiming the line.
    Physical 40-pin header pin number TBD — identify with
    `sudo gpioset --mode=signal gpiochip2 14=1` + multimeter.
2026-05-02 SP1: switch fire GPIO default to gpiochip2 line 28 (PEE.05 = Pin 32)
    PCC.02 (line 14) appears not to be routed to the 40-pin header on the
    Seeed J202x carrier — multimeter probe found no toggling pin. Switching
    to PEE.05 which is the standard Jetson Xavier NX header Pin 32 (labeled
    GPIO12 in the NVIDIA reference pinout — explicitly a user GPIO).
2026-05-02 SP1: switch fire GPIO default to PCC.04 = Pin 12 (Seeed J202 datasheet confirmed)
    Seeed reComputer J202x datasheet page 18 confirms the 40-pin header
    pinout: Pin 7 = AUD_MCLK (= our PCC.03 line 15, kernel-claimed by
    audio "mux"), Pin 12 = I2S0_SCLK / GPIO. PCC.03 → Pin 7 nails the
    PCC port adjacency, so PCC.04 (line 16, currently "unused input")
    is Pin 12. Default usage column is "GPIO" — safe to claim.
    PCC.02 (line 14) and PEE.05 (line 28) had no datasheet confirmation
    they were brought out to the 40-pin header — multimeter test on
    PCC.02 came up empty. Pin 12 is the safe choice.
2026-05-02 SP1: lock fire GPIO to gpiochip1 line 105 (PQ.05 = Pin 29 = GPIO01)
    Jetson.GPIO pin-data table reveals that the apparent "user GPIO" pins on
    the Xavier NX 40-pin header (Pin 15/32/33) all have PWM controllers
    attached (c340000.pwm, 32f0000.pwm, 3280000.pwm respectively) — the
    kernel PWM driver competes with our GPIO writes and gives garbage
    voltage readings.
    PQ.05 (Pin 29) has no alternate function listed in the Jetson.GPIO
    table beyond General Purpose Clock #0 — verified clean 0V <-> 3.3V
    toggle at 1Hz via Jetson.GPIO Python with multimeter.
    Wire Jetson Pin 29 -> Teensy Pin 2 (FIRE_PIN) and Jetson GND
    (Pin 6/9/14/20/25/30/34/39) -> Teensy GND.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
2026-05-02 LOGBOOK: SP1 Phase A+B (strobe pipeline) — Teensy firmware + Jetson PulseStrobe impl
    Master overview SP1 88% -> 92%. Hardware Components Registry updated:
    Teensy 4.0 / Cenpek IR / 12V PSU all "in hand"; MOSFET "TBD ordered";
    2N3904 + LED + 1k for bench-test "in hand".
    Setup Guide entries 35-39: Teensy firmware location/protocol, Jetson
    pulse_strobe_jetson.cpp + soft-fallback architecture, Pin 29 / PQ.05 /
    gpiochip1 line 105 fire-pin lock-in (PWM-occupied 15/32/33 explanation),
    gpiod CLI install + --mode=signal/--mode=time gotcha, three new strobing
    JSON keys.
    5 new Decisions Log rows for the strobe architecture, Pin 29 selection,
    Cenpek MOSFET switching plan, dedicated pulse_strobe_jetso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
2026-05-05 SP1 Phase C Test 1 PASS: Jetson → Teensy → LED chain validated
    Wired Jetson Pin 29 ↔ Teensy Pin 2 + GND ↔ GND + USB. pitrac_lm strobe
    init handshake completed cleanly (Teensy READY, GPIO line claimed).
    PiTrac's FSM ball-stabilization gate kept the watch loop from running,
    so SendExternalTrigger never fired through pitrac_lm itself — instead
    validated the strobe pipeline via a standalone bypass script:
    Hardware/teensy_strobe/test_strobe_bypass.py — opens /dev/ttyACM0,
    configures the Teensy with long visible pulses, claims Pin 29 via
    Jetson.GPIO, toggles 5×. All 5 fires produced visible LED flicker.
    LOGBOOK updates:
    - Master Overview SP1 92% → 95%, last-verified 02 → 05.05.2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
2026-05-05 SP1: fix motion_detect_stage hskip byte-step for CV_8UC3 (Issue #18)
    V4L2Capture engine returns CV_8UC3 BGR (cvtColor(GRAY→BGR) inside
    decode_into). motion_detect_stage's pointer math was stepping in BYTES,
    sampling B,R,G,B,R,G… instead of every Nth pixel — effective horizontal
    coverage was ~213 pixels per row instead of the configured 640 at hskip=2.
    Fix: derive hskip_bytes = config_.hskip * frame.channels() once under
    #ifdef JETSON_BUILD, replace all 4 pointer-arithmetic uses (2 initial
    x-offsets, 2 inner-loop steps). RPi branch keeps hskip_bytes = config_
    .hskip (channels = 1 implicit, original behavior).
    Issue #18 marked resolved in the Known Issues Register.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
2026-05-05 SP1: always fire SendExternalTrigger on Jetson (Issue #20)
    motion_detect_stage.cpp explicitly skipped SendExternalTrigger when
    system_mode == kCamera1TestStandalone, which made sense on RPi
    (don't pulse a non-existent cam2 system during isolated cam1 testing)
    but is wrong on Jetson — SendExternalTrigger here drives the IR strobe
    LED via the Teensy, not a remote cam2. OV9281 USB has no XTR pin
    either, so there's nothing to "skip" anyway.
    Under JETSON_BUILD: always call SendExternalTrigger when motion is
    detected, regardless of system_mode. RPi behavior unchanged.
    Was the missing piece for the in-pitrac_lm strobe trip (LED was silent
    on motion-detect trip in 2026-05-05 18:24:04 run despi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
2026-05-05 SP1: bypass FSM ball-stabilization moved-check on Jetson (Issue #21)
    WaitingForBallStabilization → "ball moved" path was bailing back to
    WaitingForBall every cycle on Jetson because HoughCircles reports
    slightly different ball positions frame-to-frame in the noisy ambient-IR
    mono image (Issue #19). Without IR strobe to give clean ball edges, the
    FSM never advances to WatchForHitAndTrigger, so the strobe pipeline
    never fires from pitrac_lm even though everything downstream is wired.
    JETSON_STUB-guarded development bypass: when ball is still found but
    reports moved, force-advance to WaitingForBallHit. When ball is
    genuinely lost (!found), original bail-back behavior preserved (we
    don't want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
    [gs_fsm.cpp]
2026-05-05 SP1: bump fire-trigger pulse width 10us -> 100us
    Phase C Test 1 followup: pitrac_lm reached the SendExternalTrigger code
    path cleanly (Issue #20 + #21 fixes both worked, FSM advanced, watch
    loop fired motion-detect, both trace logs printed) but the test LED
    stayed dark.
    Diagnosis: the 10us GPIO HIGH was on the edge of the Teensy ISR's
    reliable RISING-edge detection threshold under Linux scheduling jitter.
    Each gpiod_line_set_value call has a few us of userspace -> kernel ->
    hardware overhead, and sleep_for(microseconds(10)) can return
    significantly early under load. Effective HIGH time may have been <5us.
    The Python bypass-test script that ran 5/5 successfully used 100us.
    Bringing the C++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
    [pulse_strobe_jetson.cpp]
2026-05-05 SP1: force LOW before rising edge in SendExternalTrigger
    libgpiod 1.4.1 has been observed to leave the line in an unspecified
    state after gpiod_line_request_output despite the default_val arg
    (diagnosed via Teensy STATUS query: setup was correct, ON_PULSE_US=32000,
    trigger code path executed, log claimed pulse sent — but no LED blink).
    Hypothesis: line is staying HIGH after init, so the HIGH-sleep-LOW
    trigger pulse becomes HIGH-HIGH-LOW = a FALLING edge, which the
    Teensy ISR (RISING-edge only) silently ignores.
    Two defensive changes:
    1. After gpiod_line_request_output, explicit gpiod_line_set_value(0)
    to guarantee initial LOW state.
    2. Inside SendExternalTrigger, prepend a force-LOW +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
    [pulse_strobe_jetson.cpp]
2026-05-05 SP1: bump GPIO trigger pulse to 5ms (was 100us)
    Phase C Test 1 in-pitrac_lm follow-up: with the previous fix (force
    LOW + rising edge defensive), the LED started blinking at program-end
    (via kernel line release) but still not on runtime SendExternalTrigger.
    Diagnosis: Python bypass works at 100us not because 100us is enough
    hold time but because Python's time.sleep() has ms-scale overhead —
    the actual HIGH hold is closer to 1-10ms. C++ sleep_for is precise
    at 100us, and the Tegra/libgpiod/USB-CDC stack appears to coalesce
    adjacent gpiod_line_set_value writes within ~100us.
    Bumping HIGH hold to 5ms (50x over the suspected coalescing window).
    Still negligible vs the FSM/IPC overhead alrea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
    [pulse_strobe_jetson.cpp]
2026-05-05 SP1: replace libgpiod chardev trigger with Jetson.GPIO Python helper (Issue #22)
    libgpiod chardev (gpiod_line_set_value) does not produce a rising edge
    that the Teensy ISR sees on this Seeed J202 carrier — confirmed by
    extensive 2026-05-05 debugging:
    - Bypass-script (Python Jetson.GPIO) blinks LED reliably
    - gpioset CLI (libgpiod chardev) does NOT trigger Teensy
    - Adding force-LOW + 5ms hold + 2ms settle to pitrac_lm's libgpiod
    calls did not help
    - LED blinks at process death (kernel line release) but not on the
    explicit gpiod_line_set_value calls during runtime
    - Filed as Issue #22 (TBD)
    Workaround: shell out to Hardware/teensy_strobe/fire_trigger.py
    via std::system(). Uses Jetson.G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
    [fire_trigger.py, pulse_strobe_jetson.cpp]
2026-05-05 LOGBOOK: SP1 strobe-pipeline software-validated end-to-end
    Phase C Test 1 follow-up entry: confirmed pitrac_lm now invokes
    fire_trigger.py via std::system, and that helper script is proven
    working when invoked manually as user brain (LED blinks).
    Issue #22 added: libgpiod chardev (gpiod_line_set_value via
    /dev/gpiochip1) does not drive Pin 29 such that the Teensy ISR
    sees a rising edge — gpioset CLI confirms it's not pitrac_lm
    specific. Workaround in place via fire_trigger.py + Jetson.GPIO.
    SP1 Master Overview 95% -> 97%.
    Final FSM-driven validation deferred to Phase C Test 2 (with real
    IR LEDs), because Issue #19 (ball-stabilization unreliable without
    IR illumination) will resolve nat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
2026-05-05 SP1: fix V4L2Capture::ensure_streaming fd leak (Issue #17)
    Every failure path in ensure_streaming() now calls release() before
    returning false. release() is idempotent and tolerates any partial
    state (closes fd, frees mmaps, frees tj_handle, clears pending_ctrls).
    Also reordered: tj_handle + gray_scratch allocation moved BEFORE
    VIDIOC_STREAMON so that STREAMON becomes the unique point-of-no-return
    at the very end, with no failure paths after it. Previously,
    tjInitDecompress() failure after STREAMON would have left the kernel
    in streaming state with streaming_=false in our object — release()
    would have failed to issue STREAMOFF.
    Caller behavior: ball_watcher_event_loop's retry loop now hi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
    [v4l2_interface.cpp]
2026-05-05 LOGBOOK: 2026-05-05 (continued) session note + Next Steps update
    Comprehensive session note documenting the long debugging arc that
    landed Issues #20, #21, #22 fixes plus #17, #18 cleanup + the Python-
    helper workaround for the libgpiod chardev mystery.
    Next Steps tightened:
    - #17 fd leak — DONE
    - #18 hskip bytes — DONE
    - /dev/ttyACM0 dialout permanent fix — usermod queued (re-login needed)
    SP1 strobe pipeline: software-vollständig validiert. Awaiting
    hardware (MOSFET) for Phase C Test 2 with real IR LEDs.
2026-05-12 LOGBOOK: 2026-05-12 Phase C Test 2 PASS - strobe pipeline hardware-validated
    IRLZ44N MOSFET arrived, wired as low-side switch for Cenpek 12V IR
    array. test_strobe_bypass.py confirmed via smartphone IR-capture +
    12V PSU ampere-spike on each fire event.
    SP1 97% -> 98%. Remaining: live FSM run with IR-lit ball
    (Issues #19/#21 expected to resolve naturally), camera mounting,
    stereo calibration, first real shot end-to-end.
2026-05-12 SP1: promote Issue #21 stabilization bypass from JETSON_STUB to JETSON_DESIGN
    Live FSM run 2026-05-12 (sp1_fsm_1959.log) reproduced Issue #19
    HoughCircles jitter exactly. The bypass fired once, FSM advanced to
    WatchForHitAndTrigger, and SendExternalTrigger pushed a real fire pulse.
    End-to-end strobe pipeline now validated under live pitrac_lm, not just
    the bench bypass script.
    Root cause is permanent: Teensy LED_GATE is event-driven (only HIGH
    during a fire-burst, see teensy_strobe.ino:74), so stabilization-check
    frames are always ambient-light only. The 2026-05-05 hypothesis that
    IR strobe would resolve Issue #19 was wrong; the bypass is the
    permanent solution, not a workaround.
    Rewrites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
    [gs_fsm.cpp]
2026-08-06 SP4: bring the GSPro/dashboard stack under version control
    sp4_gspro/ was built on 2026-03-21 and has been running as two systemd
    services ever since, but it lived only on the Jetson's disk - never
    committed, so a single storage failure would have taken the whole
    sub-project with it.
    Adds the ten source files: the Flask stats dashboard, the SQLite shot
    store, the GSPro Open Connect TCP sender, the Unix-socket shot receiver,
    the ball-flight physics engine, the C++ side header, the test client,
    both unit files and the installer.
    Deliberately excluded via .gitignore, with the runtime artefacts found
    alongside them:
    - jetson_lm.db and its WAL/SHM sidecars. This is live shot history and
    s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
    [ball_physics.py, camera_test.py, dashboard.py, gspro_sender.py, shot_db.py, shot_receiver.py, shot_sender.h, test_client.py]
2026-08-06 SP1: spec for OV9281 intrinsics + stereo extrinsics calibration
    Every optical constant in the code still describes PiTrac's IMX296 hardware.
    Three of them are wrong for ours and one is wrong in a way that hides:
    sensor dimensions stay at 5.077 x 3.789 mm while capture is 1280x800 on a
    3.84 x 2.40 mm OV9281, so the aspect ratio disagrees with the image and the
    vertical world-coordinate math skews by ~19%. A focal-length calibration
    absorbs an absolute sensor-width error but not an aspect error, which makes
    this the kind of fault that stays consistent enough to look plausible.
    The spec measures rather than assumes. The 2.74 mm figure everything else
    here leans on is derived from Arducam's 70-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
2026-08-06 docs: track the V4L2 capture engine spec and plan
    Both were written on 2026-04-29 and drove the work that landed, but neither
    was ever committed. They are the record of why V4L2Capture looks the way it
    does, which is exactly the thing worth keeping.
2026-08-06 SP1: implementation plan for OV9281 intrinsics + stereo calibration
    Twelve TDD tasks: stable camera binding by USB port path, an empirical step
    to establish which port holds which physical module, sharpness and board
    detection, barrier-synced paired capture, a shared session that hands the
    cameras back when idle, a CLI, a calibration page mounted into the running
    dashboard, the reworked analysis scripts, and the same by-path binding in the
    C++ startup.
    Two decisions worth stating. Tests use unittest rather than pytest - the
    Jetson has no pytest and a working device is a poor place to add
    dependencies. And the cameras are released on an idle timeout, because a
    V4L2 node has a single owner an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
2026-08-06 SP1: bind cameras by USB port path, not /dev/videoN
    Both OV9281 modules report iSerial UC762 - Arducam's SKU code rather than a
    per-unit serial - so by-id collides and the device numbers are assigned in
    enumeration order. A swap mirrors the stereo baseline and nothing looks wrong
    in the images, so the binding fails loudly instead of falling back.
    [camera_paths.py]
2026-08-06 SP1: cover all_devices() in the camera binding tests
    It is the entry point the CLI and the dashboard blueprint actually call,
    and a half-present rig must fail loudly rather than quietly return one
    camera.
2026-08-06 SP1: sharpness metric and board detection for calibration
    find_board returns sub-pixel refined corners. PiTrac's CameraCalibration.py
    computes the refinement at line 51 and then appends the coarse corners at
    line 52, throwing it away - accuracy given up for nothing, and it matters
    more here because the stereo extrinsics rest on it.
2026-08-06 SP1: test board detection against a real capture
    Uses PiTrac's own checkerboard_test_image_for_undistortion.png as fixture -
    a genuine 1456x1088 frame - and asserts that cornerSubPix actually moved the
    corners, which is the bug the upstream script has.
2026-08-06 SP1: test find_board against colour input
    The capture path yields CV_8UC3 BGR because OpenCV decodes MJPEG to three
    channels whatever the sensor is, but every existing find_board test fed it
    grayscale. That was the one path real camera frames actually take.
2026-08-06 SP1: shared calibration session with idle camera release
    A background grabber keeps one barrier-synced pair current; streams and
    captures read it rather than touching the devices. Releases after two idle
    minutes, because a V4L2 node has a single owner and a dashboard that never
    lets go would keep pitrac_lm from ever starting.
    test_idle_timeout_releases_without_being_asked drops idle_timeout_s to 1s on
    the shared module-level SESSION; restore it in that test's own cleanup so it
    doesn't leak into later tests, per the task's guidance to restore rather
    than restructure.
    [calibration_capture.py]
2026-08-06 SP1: fix three defects in the calibration session lifecycle
    All three were in the design, not the implementation, and all three were
    found by running the suite repeatedly rather than by reading it.
    release() nulled the state under the lock and closed the V4L2 descriptors
    afterwards, so is_open() reported free while teardown was still in flight.
    Anything reopening on that signal raced the close - precisely the pitrac_lm
    handoff the idle release exists to make safe. Teardown now stops, joins,
    then takes the lock and closes the descriptors before dropping it.
    ensure_open() held a single lock across a cold camera open, blocking
    touch() and staling the idle clock. The dashboard will hit this wi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
    [calibration_capture.py]
2026-08-06 docs: correct the plan's CalibrationSession after implementation
    The block as planned carried three lifecycle defects, none of them visible by
    reading it. Leaving the plan carrying the broken version would walk the next
    reader straight into them, so it now shows what actually landed in 9e07993,
    with a note recording what was wrong and how it surfaced.
    Also raises the stated verification bar from one run to five. Every defect
    here was a race or a timing assumption, and none failed on a first run.
2026-08-06 SP1: replace the calibration session with a single-lock design
    A fourth concurrency defect turned up in review: release() snapshotted
    self._thread before taking the lifecycle lock, so a release racing an open
    could tear down the freshly opened pair and leave its grabber spinning on
    released handles while is_open() reported free. Not exotic - the
    calibration page polls sharpness through ensure_open() twice a second, so
    clicking release with a stream open lands in that window routinely.
    The minimal fix opens a new hole: moving the snapshot under the lock
    forces the join under the lock, which deadlocks against the grabber's own
    idle release, and making that path give up on contention leaves th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
    [calibration_capture.py]
2026-08-06 SP1: rework CameraCalibration.py for the OV9281
    Resolution is read from the images instead of being the IMX296's 1456x1088;
    paths become arguments; reprojection error is reported per image so outliers
    can be dropped; output is a pasteable golf_sim_config.json block instead of
    .txt files whose 3x3 matrix and 5-vector get transcribed by hand.
    Two substantive fixes beyond the mechanical ones.
    The sub-pixel refined corners are now actually used. The original computes
    cornerSubPix at line 51 and appends the coarse corners at line 52, throwing
    the refinement away - accuracy given up for nothing, and it matters more here
    than upstream because the stereo extrinsics rest on that precision.
    CHESSBO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
2026-08-06 SP1: stereo extrinsics from the same image pairs
    Solves with CALIB_FIX_INTRINSIC, since the per-camera matrices are already
    measured, and reports the result against the CAD: an 80.00 mm baseline with
    parallel axes, read from the two M12 lens barrel placements in
    Hardware/JetsonLM.step. That makes it an independent check on the calibration
    and on the physical mount at once.
    Two corrections to the planned version, both found while verifying rather
    than while writing.
    The axis decomposition had its labels rotated by one. It read the rotation
    about X as roll, about Y as pitch and about Z as yaw, while the camera frame
    is X right, Y down, Z forward - so rotation about X is pitch, about Y is yaw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
2026-08-06 docs: correct the plan's axis decomposition and shared constants
    The planned rotation_to_euler_degrees had its three labels rotated by one
    against the camera frame, which would have reported the costly misalignment
    under the name of the forgiving one. Replaced with the Rodrigues version that
    landed, and the note records why so nobody reinstates the hand-rolled form.
    Task 10 in the plan also still declared CHESSBOARD_SIZE and SUBPIX_CRITERIA a
    second time instead of importing them from sp1_vision.frame_analysis.
2026-08-06 SP4: calibration page blueprint
    Live MJPEG per camera with a sharpness readout, a capture button reporting
    board detection per camera immediately, a run button, and an explicit release
    so pitrac_lm can have the devices back.
    Focusing an M12 lens is now looking at a picture rather than judging by eye
    through a terminal. The score has no absolute meaning - it depends on what the
    camera sees - so it is drawn against the highest value seen so far, and the
    technique is to turn the lens until the bar peaks.
    The /calibration/run route was missing from the plan entirely: the page had a
    'Run calibration' button wired to an endpoint that did not exist, and could
    not have, since the two analysis scri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
    [calibration_page.py]
2026-08-06 SP4: mount the calibration page in the dashboard
    Registers the blueprint and adds a Calibration entry to the tab row, linking
    to its own page rather than becoming a sixth tab - the existing tabs are
    sections of one document, and this is a different thing with a live video
    stream in it.
    Verified by running a second instance on port 5001 against the same code:
    /, /calibration and /calibration/status all answered 200.
2026-08-06 SP1: bind cameras by USB port path in PerformCameraSystemStartup
    The two modules are indistinguishable by USB identity - same VID:PID
    0c45:6366, same bcdDevice, and iSerial UC762 on both, which is Arducam's SKU
    code rather than a per-unit serial. So /dev/videoN was the only thing telling
    them apart, and it is assigned in enumeration order. A swap mirrors the stereo
    baseline and nothing looks wrong in either image.
    Not hypothetical: the comment that stood here recorded the cameras on
    xhci-2.2.4 and xhci-2.3, and by today they enumerate on 2.3 and 2.4. The ports
    had already drifted without anyone noticing.
    Mirrors CAMERA_PORT_PATHS in sp1_vision/camera_paths.py, with a note at both
    sites say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
    [v4l2_interface.cpp]
2026-08-06 SP1: CLI front end for calibration capture
    Reports board detection per camera immediately after each pair, so an
    unusable shot surfaces while the board is still in hand rather than twenty
    shots later when the analysis rejects it.
    Opens the cameras directly rather than through CalibrationSession, and says so
    - a V4L2 node has a single owner, so this refuses while the dashboard holds
    them. That is the intended relationship: the dashboard's page is the better
    tool because it shows the live picture, and this is the fallback for when it
    is not running.
    Shot mode numbers after any pairs already on disk instead of overwriting them,
    and defaults to the same directory the dashboard writes to.
    Veri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
2026-08-06 SP1: pin camera 1 and 2 to physical modules, measured two ways
    The numbering was an assumption until now, and getting it backwards mirrors
    every stereo result with nothing visibly wrong in the images.
    Camera 1 is port 2.3 and the left module facing the unit; camera 2 is port 2.4
    and the right one. Established by covering the right-hand lens and watching
    the right-hand stream go dark, and independently by parallax: a patch from the
    centre of camera 2 matched 76 px further left in camera 1, correlation 0.95.
    Those two readings look contradictory until the frame of reference is fixed,
    which is precisely how a baseline ends up sign-flipped. Facing the unit you
    are looking back down the optical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
    [camera_paths.py, v4l2_interface.cpp]
2026-08-06 SP1: bound the exposure subprocess and halve the per-grab thread churn
    From a code-quality review of the session, which approved the design but
    found two things worth fixing before they are reachable.
    set_manual_exposure ran v4l2-ctl with no timeout, while holding the session
    lock. A wedged UVC driver would have frozen every stream, the capture button,
    the release button and the idle watchdog together, and pitrac_lm could then
    never reclaim the devices - the exact failure the idle release exists to
    prevent. Bounded at five seconds and treated as best effort: a wrong exposure
    is a worse capture series, a hang is a dead device. Dormant today, since no
    caller passes exposure_units, but one UI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
    [calibration_capture.py]
2026-08-06 SP1: fix the reprojection metric, the square size and add outlier rejection
    Three faults, all found by running the calibration for real rather than by
    reading the code.
    The per-image reprojection error divided the L2 norm by the point count
    instead of its square root. That is not an RMS and not in pixels: with 54
    corners it understates by 7.35x, so images reprojecting at 3.3 px displayed
    0.45 and the outlier flag never fired once. Inherited from PiTrac, which took
    it from the OpenCV tutorial.
    SQUARE_SIZE_MM was a guessed 20.0 against a board that measures 24. World
    scale does not touch the camera matrix or the distortion, so it was easy to
    wave away - but it scales the translation linearly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
2026-08-06 SP1/SP4: measure sharpness on the board, and stop running when nobody looks
    Two follow-ups from calibrating for real. One of them I got wrong first.
    The sharpness readout measured the central 40% of the frame regardless of
    what was in it. With the board held below the middle it reported the texture
    of the wall behind, so a properly sharp lens read 20 while a genuine focus
    problem hid underneath - an hour and a wrong diagnosis about a defective lens.
    It now measures the detected board when one is visible, says which of the two
    it is showing, and resets its running peak when that switches, since the
    scales differ by an order of magnitude.
    The heat: I proposed running the sensor at 30 fps ins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
    [calibration_capture.py, calibration_page.py, frame_analysis.py]
2026-08-06 SP1: put the measured optics into the config and the sensor override
    Until now every optical constant described PiTrac's IMX296 with a 6 mm lens.
    The hardware is an OV9281 with a 70 degree M12, and the two have almost
    nothing in common.
    Measured on 2026-08-06 from 20 simultaneous checkerboard pairs:
    focal length 2.767 / 2.772 mm was 6.222 / 5.903
    sensor 3.840 x 2.400 mm was 5.077 x 3.789
    fx 922.3 / 924.0 px was 1833.5 / 2340.3
    k1 +0.015 / +0.053 was -0.509 / -0.818
    The distortion coefficients are worth a second look: an order of magnitude
    smaller than the IMX296 values and of the opposite sign. The lens really is
    the low-distortio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
2026-08-06 SP1: save the stereo extrinsics rather than leaving them in a scrollback
    R and T are the product of a whole capture session - focusing two lenses,
    twenty hand-held pairs, an hour of work - and nothing downstream consumes them
    yet, so until now they existed only as terminal output. Losing them would have
    meant recapturing everything.
    Measured 2026-08-06 with a 24 mm board over 20 pairs:
    baseline 79.83 mm against 80.00 from the CAD
    translation [79.79, 0.13, 2.60] mm
    rotation pitch 1.070, yaw 0.756, roll 0.925 degrees
    The 2.60 mm in Z is not a mounting error: the lenses were focused by screwing
    them in and out, which moves each optical centre along its own axis by exactly
    that so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
2026-08-06 SP1: keep the calibration capture set as evidence
    42 MB, deliberately. Every optical constant now in golf_sim_config.json came
    out of these forty frames, and regenerating them means another hour standing in
    front of the cameras holding a board. A better analysis later - a distortion
    model with more terms, a stricter outlier rule, a rectification check - should
    be able to run against the same data rather than start from nothing.
    The README records what the numbers depend on. Chiefly the 24 mm square size:
    it scales the translation linearly and therefore sets the stereo baseline
    outright, and assuming 20 mm against this board produced 66.40 mm where the
    truth is 79.83 - which read convincingl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
2026-08-06 LOGBOOK: 2026-08-06/07 — cameras measured, every optical constant was wrong
    The session that turned the optics from assumption into measurement, and found
    that the assumptions were not merely imprecise but belonged to a different
    Focal length 6.222/5.903 -> 2.767/2.772 mm. Sensor 5.077x3.789 -> 3.840x2.400.
    Baseline 79.83 mm measured against 80.00 from the CAD, by two independent
    routes. Reprojection RMS 0.56 px over 20 hand-held pairs.
    Three issues added to the register. #23 is the one that matters: the IMX296
    matrix was not sitting inert in the config, it was live, and every still that
    ball detection consumed was being remapped through the wrong lens model. The
    2026-04-29 note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
2026-08-08 SP1: archive the springs-era capture set before recapturing over it
    Removing the mount springs moved the cameras relative to each other, so the
    extrinsics have to be measured again. The intrinsics do not: no lens was
    touched, and focal length, principal point and distortion belong to the lens,
    not to how the pair is aimed.
    That split is the reason for the move. Both capture paths write into
    calibration_images/cam1|cam2 and number after whatever is already there -
    _pair_count() + 1 in the dashboard, existing in cli_calibrate.py - and the
    dashboard's IMAGE_ROOT takes no argument. Capturing now would have laid the new
    pairs beside the old twenty, and the analysis reads the whole directory: one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
2026-08-08 SP1: the sharpness readout is a relative instrument, not an absolute one
    I had written "both cameras should read near 3000, as on 2026-08-06" into the
    recapture sheet. That is wrong, and wrong in the direction that causes work:
    Laplacian variance scales with the square of scene contrast and with how large
    the board sits in the frame, so 3028 / 2945 described that evening's lamp and
    that evening's board distance and nothing else. Someone following it in a
    dimmer room would have read 1050, concluded the lenses had drifted, and gone
    looking for a fault that is not there.
    Measured on the hardware just now with the board propped: cam1 1035-1062,
    cam2 1066-1083 over seven samples. A factor of 2.8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
2026-08-08 SP1: post-rebuild extrinsics, and the uncertainty the RMS does not show
    18 pairs, board found in both cameras in all 18, one dropped by the solve
    (gs_01, the 250 mm shot - which fitted at all only because it was placed within
    the 27 mm of lateral play the 80 mm baseline leaves at that distance). Depth
    250-928 mm against the archive's 350-550. Stereo RMS 0.9044 px against 1.1819.
    pitch +1.070 -> -0.745 deg
    yaw +0.756 -> +0.226 deg
    roll +0.925 -> -0.700 deg
    base 79.83 -> 78.59 mm
    The rotation is stable and that was checked rather than assumed: re-solving on
    halves, odds, evens and with the distance sweep held out keeps pitch within
    -0.72..-0.83 and roll within -0.70..-0.75.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
2026-08-08 SP1: six shots into the lower frame, and the intrinsics change hands
    The 18-pair set left pitch uncertain by 1.1 deg, because neither it nor the
    archive covered the bottom fifth of the frame and pitch is largely a readout of
    the relative cy between the two cameras. Six more pairs into the lower third -
    centre at 35/45/55/75 cm, left and right at 45 - take corner coverage from
    y=641 to y=727 of 800 and cut that uncertainty to 0.21 deg.
    That settles cy, and settling cy settled everything downstream.
    intrinsics archive 24 pairs
    cam1 fx/fy 922.30 / 917.97 900.38 / 897.39
    cam2 fx/fy 923.98 / 919.42 899.99 / 895.70
    cy 389.05 / 393.50 420.05 / 421.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
2026-08-08 LOGBOOK: 2026-08-08/09 — springs out, everything remeasured, the RMS lied
    The session that recaptured the calibration after the mount rebuild, and found
    that the number everyone trusts to judge a calibration could not see the error
    that mattered.
    Pitch came out -0.745 deg against the archive's intrinsics and -1.834 against
    the new set's, at an identical RMS of 0.90. The data could not choose. Cause was
    cy, unconstrained because no capture set had ever covered the bottom fifth of
    the frame: 17.6 px of difference in cy1-cy2 over a focal length of 915 is
    1.10 deg, against an observed gap of 1.09. Six shots into the lower third cut it
    to 0.21 and pulled cy to within 1.0 px between the cameras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
2026-08-09 CLAUDE.md: bring it in line with the finished calibration
    It still told the next session that the intrinsics were 2.767/2.772 and that the
    archived set was their source, and to solve extrinsics against the archive. All
    three became wrong yesterday: the 24-pair set replaced the archive on every
    figure, and the archive is now only the record of the pre-rebuild geometry.
    Following the old text would have mixed one set's intrinsics with another's
    extrinsics - the one combination that is definitely wrong and that the
    reprojection error cannot see.
    Also records the two general lessons rather than only the numbers: that
    intrinsics and extrinsics are only self-consistent as a pair under
    CALIB_FIX_I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
2026-08-09 SP1: name the geometry constants the code actually reads
    I had written kCameraNPositionsFromOriginMeters into CLAUDE.md and the logbook as
    the thing to fix next. It does not exist in this tree. It appears only in
    PiTrac's docs/camera/camera-calibration.md, and the constant the code declares,
    loads and reads is kCameraNPositionsFromExpectedBallMeters - which means the
    origin is the expected ball position, not a point on the floor, so the question
    "where is the origin" was largely answered already.
    Three corrections follow from reading the live path rather than the docs:
    Only the magnitude of that vector is consumed, at gs_camera.cpp:455/458 through
    CvUtils::GetDistance, as the expected ball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
2026-08-09 SP1: design for stereo triangulation and the world geometry
    Block 1 of two: triangulation as a measuring instrument in Python, before
    any of it enters the C++ runtime path. Building it in pitrac_lm first would
    mean debugging it where no trusted reference exists.
    The constant CLAUDE.md names does not exist in the live code. It reads
    kCameraNPositionsFromExpectedBallMeters, and consumes only the vector's
    norm as a ball-search prior - so that entry is 0.509 m and nothing more.
    kCamera2OffsetFromCamera1OriginMeters is the one that matters and was not
    on the list: it still carries PiTrac's 19 cm of vertical camera stacking.
    Camera 1 is the golfer's left module, confirmed three ways - the sign o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
2026-08-09 SP1: implementation plan for triangulation block 1
    Eight tasks, TDD throughout, tested against synthetic geometry rather than
    images so the arithmetic is not confounded with detection error.
    The frame conversion gets its own task and its own review gate. It is the
    one place a sign error is both easy to make and invisible afterwards, and
    -R.T @ t is not -t: dropping the rotation gets the small components wrong
    by more than a factor of two.
    Capture prompts for the tape reading and the target-line flag per shot and
    writes them beside the images. Yaw cannot be recovered from a floor-only
    series afterwards, so the tool refuses to call a run complete without two
    target-line positions rather than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
2026-08-09 plan: label each capture series, so the scale fit gets only collinear points
    Pre-flight review of the plan found the scale fit reading from every floor
    shot, not just the collinear depth line. It equates a 3D separation with a
    difference of two tape readings - true along one line, false the moment a
    laterally offset position joins in. A spread shot 250 mm to the side of a
    depth shot 10 mm further out contributes a 250 mm measurement against a
    10 mm tape gap, which does not bias the least-squares fit so much as
    destroy it - and that fit is what was meant to settle 78.28 against 78.749.
    run.json now carries series = depth | spread | target instead of a
    target_line boolean. Plane takes depth+s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
2026-08-09 SP1: load the stereo rig, in metres, and refuse a wrong one
    [stereo_geometry.py]
2026-08-09 docs: correct the baseline validation bound, which could not do its job
    The spec and plan both gave 0.05-0.12 m as the sanity bound on the stereo
    baseline, with the stated purpose of catching a wrong checkerboard square
    size. It could not: 20 mm assumed against the 24 mm board actually used
    yields 66.40 mm, which sits comfortably inside that range - and 66.40 mm is
    the very number the plan's own test feeds in expecting a rejection.
    Found by the Task 2 implementer, who shipped 0.070 / 0.090 and made the
    test pass for the right reason. Margin remains ample against the measured
    78.7 mm and its 77.99-78.66 mm subset spread.
    The plan keeps its original numbers with the correction beside them -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
2026-08-09 SP1: the Y-up conversion, and camera 2's offset computed not typed
    Adds to_pitrac_frame (OpenCV Y-down to PiTrac Y-up, self-inverse),
    camera2_centre_in_camera1 (-R.T @ t, not -t, in OpenCV axes), and
    camera2_offset_from_camera1 (the composed value for
    kCamera2OffsetFromCamera1OriginMeters).
    One test tolerance loosened from the brief's literal places=9 to
    places=7 on the norm-preservation check: the fixture's R is
    calibration output rounded to 7 decimals, so R.T @ R deviates from
    identity by ~8.6e-8, not float64 epsilon, and 9-decimal agreement
    was asserting the literal's own rounding rather than anything about
    the implementation. Confirmed by computing R.T @ R - I on the target
    Jetson befor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
    [stereo_geometry.py]
2026-08-09 SP1: triangulate a point, and reproject it to see if it is real
    The swapped-correspondence test needed a pitched rig: with R = I and
    identical K in both cameras, [T]_x is skew-symmetric, so the epipolar
    constraint holds for the swapped pair too and reprojection error is
    exactly zero - a mirrored-depth point, not a caught mistake. The real
    rig always carries the mount's pitch, so the test now does too.
    [triangulate.py]
2026-08-09 SP1: correct the reprojection residual's claimed scope, add the swap counter-case
    Review found the module docstring overclaimed: a residual computed from
    the same rig it is checking against is self-consistent with a swapped or
    inverted rig, not a guard against one. At R = I it is exactly zero for a
    swap - z' = -Z, a real mirrored intersection, not a caught mistake. Narrow
    the docstring and the degenerate-triangulation error message to what the
    residual actually catches, and add tests: the R = I swap counter-case
    beside the pitched-rig swap test (renamed to say what it now proves),
    TriangulationError's only test (parallel rays from a repeated point), and
    an assertion in make_rig() that camera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
    [triangulate.py]
2026-08-09 spec: the reprojection residual does not catch a swapped pair
    The design doc said the residual 'catches swapped cameras, inverted signs and
    mis-associated points immediately'. Two thirds of that is false, and the
    claim was load-bearing: the per-measurement validity flag was to be trusted
    on its strength.
    On a rectified rig a swapped correspondence solves exactly to Z' = -Z,
    X' = -(X+b), Y' = -Y - a real ray intersection, residual identically zero.
    E = [T]_x R is skew-symmetric at R = I, so the epipolar constraint is
    swap-invariant. An inverted translation is worse: the residual is computed
    from the very extrinsics it would have to indict.
    Found when the Task 4 implementer could not make th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
2026-08-09 SP1: fit the floor, and read pitch and roll off its normal
    The literal brief formula pitch_deg = arcsin(n[2]) reports the negated
    pitch: in this Y-down, Z-forward camera frame, pitching up rotates the
    level normal (0,-1,0) to (0,-cos,-sin), not (0,-cos,+sin) as the brief's
    docstring assumed. Verified numerically against the test fixture's own
    rotation before fixing it to pitch_deg = -arcsin(n[2]); confirmed by
    temporarily negating both signs and watching the attitude tests fail for
    the expected reason, then restoring the correct version. Roll's
    arcsin(n[0]) was already correct as written.
    [ground_plane.py]
2026-08-09 SP1: fix the fixture's inverted rotation, restore nose-up pitch, correct roll
    Review found the previous commit's fixture bug in the wrong place: I had
    flipped attitude_from_plane's pitch sign to agree with floor_points, but
    floor_points itself was wrong. Rotating fixed world points by R models a
    camera rotated by R.T, not R - so floor_points(pitch_deg=+1.7) was building
    a camera pitched DOWN, and I'd matched the formula to that inverted
    convention instead of catching it. Fixed by dropping the erroneous .T in
    floor_points (pts @ (rz @ rx) instead of pts @ (rz @ rx).T), which restores
    the brief's original pitch_deg = arcsin(n[2]) with positive = nose-up, and
    switches roll to roll_deg = -arctan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
    [ground_plane.py]
2026-08-09 SP1: swap to the exact pitch/roll pair, tighten the combined-angle tolerance
    Both attitude_from_plane formulas were the inexact ones: arcsin(n[2]) for
    pitch and arctan2(n[0], -n[1]) for roll each drop a cos(other-angle) factor
    the other formula's ratio would have cancelled. Swapped to
    pitch_deg = arctan2(n[2], -n[1]) and roll_deg = -arcsin(n[0]), both exact
    for this module's Rz(roll) @ Rx(pitch) composition - verified against the
    fixture up to 45/30 deg pitch/roll, matching to 1e-9 deg, and stress-checked
    locally at assertAlmostEqual places=6 before settling on places=3 to match
    the neighbouring single-angle tests. test_recovers_both_together no longer
    needs the looser places=2 tolerance the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
    [ground_plane.py]
2026-08-09 SP1: fix cli_triangulate crash-safety, resume robustness, and corruption handling
    Three fixes for capturing a triangulation series:
    1. Removed unused 'import time' (carried from brief code block).
    2. Made manifest write crash-atomic:
    - Write to temporary file via tempfile.mkstemp
    - Atomically replace using os.replace()
    - Prevents losing metadata if interrupted mid-write
    3. Fixed resume path robustness:
    - Added _find_max_shot_number() to detect images on disk
    - Resume numbering now uses max(manifest_entries, disk_images)
    - Warns if manifest and disk diverge (crash recovery indicator)
    - Prevents silent image overwrite if manifest/disk desync
    4. Added error handling for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
    [cli_triangulate.py]
2026-08-09 SP1: extract manifest logic from cli_triangulate, test it for real
    _load_manifest, _write_manifest and _resume_start_number are pulled out
    of run_shots (unchanged behaviour) so they can be called directly from
    tests. The old test_cli_triangulate.py mostly did not test the
    production code: two tests grepped inspect.getsource(run_shots) for
    literal strings like "mkstemp", which would still pass with the
    cross-filesystem bug reintroduced; others re-implemented the logic
    inline instead of calling it. Those are replaced with tests that call
    the extracted functions and check real outcomes: no .tmp left behind,
    previous manifest intact when a write raises, write/load roundtrip,
    malformed JSON and m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
    [cli_triangulate.py]
2026-08-09 SP1: analyse a triangulation run - attitude, scale, and the config values
    Adds fit_scale_factor to triangulate.py (least-squares scale between
    triangulated and tape-measured displacements) and run_analysis to
    cli_triangulate.py, wired behind --analyse.
    _measure_shot rejects a shot unless BOTH the reprojection residual is
    under MAX_REPROJECTION_PX and the triangulated point is in front of
    camera 1. The residual alone does not reliably catch a left/right
    camera swap: on a rig with R = I a swap solves to Z' = -Z with an
    exactly zero residual, so the sign of Z is the guard that holds
    regardless of this rig's mount pitch. Covered by a new TestMeasureShot
    class in test_cli_triangulate.py, includi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
    [cli_triangulate.py, triangulate.py]
2026-08-09 SP1: fix task-7 review findings - test run_analysis, guard exceptions, un-settle pan's sign
    - Commit a real test for run_analysis (RunAnalysisTest) instead of resting
    on a deleted smoke script. Patches stereo_geometry.load_rig as a module
    attribute of cli_triangulate (no production DI needed), builds a
    synthetic manifest and image pairs, and asserts: a spread shot's tape
    value cannot leak into the scale fit, all four _measure_shot rejection
    reasons appear distinguishably (including the R=I depth-sign-only
    case), and the config block prints.
    - Catch StereoRigError around load_rig/validate_rig and PlaneFitError
    around fit_plane/attitude_from_plane and yaw_from_target_line, printi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
    [cli_triangulate.py]
2026-08-09 SP1: test run_analysis's exception guards directly
    Closes a gap I flagged in my own review: the StereoRigError/PlaneFitError
    catches added around load_rig/validate_rig and fit_plane were only
    exercised implicitly by the happy-path test. Adds two tests that mock
    each error directly and assert run_analysis returns 1 with the error
    message printed rather than letting the exception propagate.
2026-08-09 SP1: separate the measured attitude from PiTrac's lossy angle constant
    run_analysis's tail previously printed the floor plane's pitch/roll,
    then yaw, then jumped straight to "--- values for golf_sim_config.json
    (enter by hand) ---", which quietly made PiTrac's two-element
    [pan, tilt] constant read as the destination for a measurement that
    owes it nothing - this project is a base PiTrac was built from, not a
    port constrained by its data model.
    Splits the tail into two sections. First, "measured attitude of the
    unit": pitch, roll, and yaw together, each with its physical meaning
    stated, plus the fit quality (floor position count, plane rms,
    conditioning) that qualifies them - the result in it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
2026-08-09 SP1: one resolution constant, and the -T shortcut told accurately
    EXPECTED_IMAGE_SIZE and calibration_capture's FRAME_WIDTH/FRAME_HEIGHT were
    two literals for one number. The capture size and the size the intrinsics
    assume cannot be allowed to drift apart, so the latter now reads the former.
    Also notes what validate_rig's image-size check can and cannot do: load_rig
    never sets image_size, so against a loaded rig it compares the default with
    itself. The check that bites is on the frames, and it lives in _measure_shot.
    And camera2_offset_from_camera1's docstring claimed -T alone "gets the Y and
    Z components wrong by more than a factor of two". Half true. Y is wrong in
    SIGN and 3.2x in size;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
    [calibration_capture.py, stereo_geometry.py]
2026-08-09 SP1: the floor also measures the mounting height, and yaw's sign is not pitch's
    Three things about ground_plane, all of them about not being trusted for the
    wrong reason.
    GOLF_BALL_RADIUS_M was dead. It is now the whole of a new measurement:
    dot(centroid, -normal) is the camera's height above the plane through the
    ball CENTRES, and the floor is one radius further away - so the radius is
    ADDED. (The review asked for it subtracted, which returns 72 mm where the
    spec says 115. The fixture's 0.0937 m ball height is 0.115 minus one radius,
    which is where the 115 comes back from.) This is the only direct measurement
    of a mounting height the rest of the project only assumes.
    yaw_from_target_line'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
    [ground_plane.py]
2026-08-09 SP1: measure how straight the depth line was, and refuse a depth of zero
    straightness_rms_m: RMS deviation of a point set from its own best-fit 3D
    line. The depth series is meant to run along one straight line and nothing
    checked that it did; a wobble is indistinguishable from detection noise
    inside the scale residual, so it gets its own number next to the scale it
    would otherwise have biased.
    Taken from the two smaller singular values rather than as
    (total - along^2): that subtraction cancels two nearly equal large numbers
    and leaves 2 nm of rounding on an exactly-straight line that happens not to
    be axis-aligned, which is a millimetre-scale readout claiming precision it
    does not have.
    de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
    [triangulate.py]
2026-08-09 SP1: the gate now requires spread, and the scale fit measures what the tape does
    Two blocking defects.
    The completeness gate green-lit a series the analysis cannot use. Six depth,
    two target, zero spread satisfies depth >= 4, target >= 2 and depth + spread
    >= 3 - and six depth positions are a LINE. fit_plane refuses it and pitch,
    roll AND yaw are lost together, after the unit has been moved and the floor
    marks swept up. Spread is now a requirement in its own right, with a message
    saying what spread is FOR: lateral extent across the image width, not shot
    count.
    The scale fit compared differences of a PERPENDICULAR tape reading against
    norm(xyz_b - xyz_a), a 3D point-to-point separation. Tho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
2026-08-09 SP1: prose cleanup after the fix wave - five things that said the wrong thing
    Nothing here changes a computed number.
    The comment above the floor/scale split still described the estimator B2
    removed: "it equates a 3D distance with a difference of two tape readings,
    and that identity holds only along the collinear depth line." That identity
    is exactly what went. It now says what the code does - depth differences
    against perpendicular tape differences, the same quantity on both sides - and
    why the depth positions should still be laid along a line even though the
    estimator no longer depends on it: an uncontrolled layout is an uncontrolled
    measurement, and straightness_rms_m is there to expose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
    [cli_triangulate.py, triangulate.py]
2026-08-09 docs: the depth-sensitivity formula takes depth, not range
    The spec said 3.65 mm per pixel of disparity error at the working distance,
    and explained the gap against CLAUDE.md's 3.55 as two valid readings of the
    same geometry. That explanation was wrong and I wrote it.
    dZ/dd = Z^2/(b*f) takes the ball's DEPTH - its Z coordinate along the
    optical axis. I substituted the 508.7 mm straight-line range. The owner
    confirmed every distance he supplied was measured in the vertical plane -
    the long cathetus, not the hypotenuse - and since the unit stands level the
    optical axis is horizontal, so that leg IS the depth: 500 mm. With the
    committed 78.71 mm baseline that gives 3.53 mm/px at 141.7 px of di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
2026-08-09 SP1: 3.65 mm/px is an error carried forward, not a second convention
    The owner confirms every distance he supplied was measured in the vertical
    plane - the long cathetus from the lens plane to the ball, not the hypotenuse
    from camera to ball. So 500 mm is the horizontal leg, and with the unit level
    the optical axis is horizontal and that leg IS the ball's Z. It is the depth
    this formula wants, unmodified, and 3.53 mm/px is the figure.
    The previous docstring called 3.65 a second valid reading of the same
    geometry. It is not. It came from putting 508.7 mm - the straight-line RANGE
    to the ball centre - into a formula that takes a depth, and it answers a
    question about a ball at a depth we do n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
    [triangulate.py]
2026-08-09 SP1: fit the scale as a line through every depth position, not two endpoints
    The consecutive-differences estimator telescoped. For equally spaced
    positions its least-squares fit through the origin collapses to exactly
    (Z_last - Z_first) / (tape_last - tape_first): the four interior positions
    of a six-position series contributed nothing at all. It also discarded
    every repeated measurement, since a repeat has a zero tape gap, and said so
    in a line the operator would read as a complaint about their own layout.
    fit_scale_regression fits depth = scale * tape + offset over all of them.
    The intercept carries the unknown lens-plane offset that differences were
    there to cancel - and reports it, whic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
2026-08-10 SP1: the capture protocol, and the tape prompt that no longer matched it
    The operator prompt still said "measured PERPENDICULAR to the unit's front
    face". That was right for the consecutive-differences estimator and is
    wrong for the regression: the reading is now taken along a rule the balls
    sit beside, at the ball's near edge, and the constant radius and the rule's
    zero both land in the fit's intercept.
    Two things the protocol had to get right that were not obvious:
    The ball must NOT sit on the rule. It would then ride a rule's thickness
    above every spread and target ball, and the plane fit would tilt to split
    the difference between two parallel planes - taking pitch and roll with it,
    sil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
    [cli_triangulate.py]
2026-08-10 SP1: say plainly that the capture is manual, one Enter per shot
    The protocol described what to type without ever saying that nothing fires
    by itself. It is a terminal program with no timer and no background series:
    all 24 shots are triggered by hand, and the single Enter grabs BOTH cameras
    at once - not one trigger per camera.
    Two things that only show up on the floor: the "place the ball" prompt
    arrives after the ball has long been placed, and what it actually means is
    "nobody is in frame any more". And the keyboard belongs beside or behind
    the unit, outside the field of view, or the operator walks back and forth
    24 times to stay out of their own photographs.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
2026-08-10 SP1: find the ball as a stereo PAIR, because one image cannot tell
    The 2026-08-10 run measured a loudspeaker. find_ball returned the strongest
    Hough circle in each image independently, and in 17 of 24 frames that was
    the same background object at the same pixel while the ball moved across the
    table - a ball that does not move is not a ball, and nothing in a single
    image could have said so. gs_03 even passed the 2 px reprojection gate:
    both cameras had locked onto the same loudspeaker, so the rays met
    beautifully at 1295 mm. A small residual means the cameras agree with each
    other, not that they are looking at a ball.
    Worse than the run: run_shots printed "cam1 ball cam2 ball -> keep" for al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
2026-08-10 SP1: the protocol now says what actually failed, and how to see it
    The background section was three lines about "nothing round and bright".
    That was the whole failure mode and it read as housekeeping, so it now
    carries the evidence: 17 of 24 frames returned the same pixel while the
    ball moved, and nine more are refused today because two ball-shaped
    objects genuinely sit in the measurement volume. Detecting that is not
    the same as clearing it.
    The test-shot section checked for "cam1 ball cam2 ball", which is exactly
    the message that validated nothing. It now shows the real one and, more
    importantly, tells the operator to read the NUMBERS - Z against the tape,
    Y positive, size small - rather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
2026-08-10 LOGBOOK: 2026-08-10 — the measurement run measured a loudspeaker
    The entry the failure earns, and the two Next Steps it changes: ball
    detection is now a stereo-pair decision, and the run itself is repeated
    rather than rescued.
    Worth keeping beyond this project: gs_03 passed the 2 px reprojection gate
    at 1.96 px while both cameras looked at the same loudspeaker 1295 mm away.
    A small residual means the cameras agree with each other. It has never
    meant they are looking at the right thing, and now there is real data
    saying so.
2026-08-11 SP1: a resting ball is below the optical axis, and is one size in both images
    Run 2's third shot found nothing while the ball sat plainly on the rule.
    The cause was the detector's accumulator threshold: at 22 the ball was
    present in camera 2 and ABSENT in camera 1. A white ball on light wood has
    weaker gradient support than one against a dark speaker, and 22 sat on that
    edge.
    Lowering it alone made things worse, which is the useful part. At 18 the
    ball was found - and so were spurious pairs that cleared the volume, the
    residual and the size gate, turning two good shots into "ambiguous". More
    recall without more discrimination is not progress.
    The discrimination was sitting there unused, in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
2026-08-11 SP1: derive the radius window from the volume instead of typing it twice
    The declared measurement volume started at 0.25 m; the detector's radius
    window stopped at 70 px, which is a ball at about 0.26 m. Anything nearer
    was invisible to a tool that claimed to be looking for it, and the two
    numbers lived in different modules with nothing comparing them.
    Found while chasing a different failure, and it was NOT that failure's
    cause - the first estimate of the bound said 77 px at 0.25 m by using depth
    where the ball's RANGE belongs. A ball resting on the surface sits a hand's
    breadth below the axis, so its range at a given depth is longer and its
    apparent radius smaller: 72 px, not 77. The test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
    [ball_pair.py]
2026-08-11 SP1: an outline fit that works synthetically and not on real balls
    refine_ball collects Canny edges around a Hough seed and fits a circle to
    their geometry alone, ignoring gradient polarity. That is the right idea:
    HOUGH_GRADIENT votes along the gradient direction, so where a ball is
    darker than what is behind it the edge votes AWAY from the true centre, and
    a ball lit from one side therefore lands on its bright arc - differently in
    each camera, which see the shading from different angles. On real frames
    that showed as 2.71 px of reprojection error with the ball plainly visible
    in both images: 10 mm of depth where the budget is 1.8 mm.
    Synthetically it is a clear win. 1.58 px down to 0.26 p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
    [frame_analysis.py]
2026-08-11 SP1: three real stereo pairs, because synthetic discs kept lying
    Every detector change on 2026-08-10/11 was convincing against drawn circles
    and behaved differently against a real ball - dimples, a printed logo, wood
    grain, one-sided light. Twice a test went green before the function it was
    meant to exercise had been wired in at all. Synthetic fixtures stay: they
    are the only place truth is known exactly. They are not sufficient.
    cluttered_ball the positive control. A loudspeaker with a woofer, a
    tweeter and a sphere on top, all stronger circles than
    the ball. The detector of that day returned the
    loudspeaker in 17 frames of 24; t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
2026-08-11 SP1: fit the silhouette, not the brightest arc - the goal test is green
    test_a_ball_lit_from_one_side_is_found is a plain passing test now: the
    goal pair resolves at 0.45 px where Hough alone disagreed by 2.71 px and
    the shot was rejected. MAX_REPROJECTION_PX untouched.
    refine_ball keeps the outermost Canny edge per angular direction (dimples
    and logos are interior; least squares over them collapsed 42.7 to 25.5 px
    on real frames) and MAD-trims the fit (a cast shadow's rim is exterior
    and crisper than the shadow-side flank; untrimmed outermost walked onto
    it, 60.8 to 87.3 px, on a live pair). New guard: the refined radius must
    stay within 25% of its seed - a refinement is a correction, not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
    [ball_pair.py, frame_analysis.py]
2026-09-23 SP1: discard the frame the driver held back - the run was one shot late
    After a pause the first read returned the frame taken just after the
    previous read, BUFFERSIZE 1 notwithstanding. cli_triangulate waits for
    Enter and reads once, so the 2026-09-23 measurement run recorded every
    ball at the mark before the one typed in: gs_01 shows no ball, and Z read
    ~50 mm short of the tape live. Proven on the hardware by switching exposure
    between grabs: the first grab after the switch still had the old brightness.
    grab_with_skew now discards STALE_FRAMES (measured 1, one spare) by
    default, in both cameras in parallel before the barrier. Only the
    dashboard's MJPEG stream opts out; it reads back to bac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
    [calibration_capture.py, calibration_page.py]
2026-09-23 SP1: runs 4 and 5 recorded - yaw sign settled, scale waits on contrast
    Run 5, the first with correct frames, settles the yaw sign (positive =
    target line to the right) and gives a provisional attitude against the
    desk. It cannot settle the scale: the ball had 1.3 grey levels of
    contrast in cam2, refine_ball was accepted on no shot, and raw Hough
    centres on a 1 px grid set a 7.6 mm repeat spread - 6.8 mm on the
    untouched ball alone.
    PROTOCOL.md now asks for a dark cloth, light from the camera side, marks
    instead of a rule against the ball, a contrast check before shot 1, and
    empty-scene frames. The CLI help points there instead of repeating a
    stale 12-shot layout.
    Three fixtures' readings w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
    [cli_triangulate.py]
2026-09-24 SP1: run 6 recorded - a contrast refiner for bright surrounds, scale still open
    Run 6 (2026-09-24) laid a black towel under the whole field. It is light
    grey to the cameras (~115 grey levels; dyes go transparent in the near
    infrared), and refine_ball takes its Canny thresholds from the ROI's median
    brightness - ~75/150 against a far ball's silhouette gradient of ~50. Every
    shot beyond 550 mm lost its outline and fell back to raw Hough, circles up
    to 4 px off in one camera: 13.4 mm residual on the depth line.
    refine_ball_by_contrast judges an edge against the ball's own contrast
    (half its typical edge strength, and 0.75 of the strongest edge on the same
    ray, which is what keeps the cloth tex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
2026-09-24 SP1: the board's squares are 24.27 mm - baseline 78.75 -> 79.64 mm
    Every stereo solve used 24.0 mm squares, "measured with a ruler" one square
    at a time - where half a millimetre is 2 %. Across the whole printed board
    the owner measured 194.5 mm over 8 squares and 121.0 mm over 5: 24.27 mm.
    The square size scales the stereo translation and nothing else - rotation,
    residual and every intrinsic are independent of it - so the extrinsics
    were corrected in place by 24.27/24.0 = 1.01125 rather than re-solved, and
    the pairing rule (intrinsics and extrinsics from one solve) still holds.
    Baseline 78.75 -> 79.64 mm, -0.5 % from the CAD's 80.00; the "-2.1 % print
    shrinkage" was mostly this.
    That was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
2026-09-24 LOGBOOK: 2026-09-24 closed - scale settled, next session opens with the strobe
    Run 6, the contrast refiner and the 24.27 mm square size are recorded; the
    static ambient-lit runs are closed. The owner is soldering the strobe
    circuit tested on 2026-05-12 onto a perfboard - the wire list is in the
    entry, and CLAUDE.md opens the next session with the bypass test.
2026-10-08 SP4: repeat the GSPro heartbeat every 2 s while a simulator is connected
    Golfinator (plan 3b-1) greys its launch-monitor status after 5 s without a message; until now heartbeats only went out
    on events (connect, waiting for ball once, ball found). A timer thread repeats the last heartbeat state; one recursive
    send mutex keeps shots and heartbeats from interleaving (a send can re-initialize the socket, which sends a heartbeat).
2026-10-08 SP4: clean receiver teardown and automatic reconnect for the GSPro socket
    When the simulator closed the socket, the next send called DeInitialize, which pthread_cancel'ed the receiver and dropped a
    still joinable std::thread (std::terminate). DeInitialize now shuts the socket down, joins the receiver (detaches if it
    runs on the receiver itself) and closes the socket. The heartbeat timer reconnects every 2 s while an interface is not
    connected (first failure at warning level, further ones at trace level), holds send_mutex_ around scan and send, and
    repeats the stored heartbeat state without overwriting it. GolfSimIpcSystem::ShutdownIPCSystem checks producer_ for null
    (test_sim_message never i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
    [gs_gspro_interface.cpp, gs_ipc_system.cpp, gs_sim_interface.cpp, gs_sim_interface.h, gs_sim_socket_interface.cpp, gs_sim_socket_interface.h]
2026-10-08 SP4: bound the simulator connect to 3 s
    A simulator PC that silently drops the SYN (Windows firewall, program closed) blocked the connect for the kernel
    timeout while the heartbeat timer held the send mutex, so shots waited behind it.
2026-10-08 SP4: heartbeat timer logs a failed re-connect once itself (no error lines from the connect attempt)
    [gs_sim_interface.cpp]
2026-10-08 SP4: start without a simulator; only the heartbeat timer connects, and never under the send mutex
    InitializeSims keeps the interface and starts the timer when the first connect fails (one warning). The timer tears a lost
    connection down under send_mutex_ (quick), connects without the mutex and publishes the connection by setting the now
    atomic initialized_ last, so FSM heartbeats and shots never wait for a connect. Sends no longer re-initialize on their own;
    they fail fast while not connected. The first failure's warning carries its cause, a requested teardown no longer logs
    a lost connection.
    [gs_gspro_interface.cpp, gs_sim_interface.cpp, gs_sim_interface.h, gs_sim_socket_interface.cpp, gs_sim_socket_interface.h]
2026-10-08 SP4: atexit hook also closes the simulator connections (receiver thread must not log during static destruction)
2026-10-22 DeviceID from kLaunchMonitorIdString, named "JetsonLM"
    Shots and heartbeats sent the hard-coded "PiTrac LM 0.1"; Format() now sends the configured
    launch-monitor id (kLaunchMonitorIdString, default and config "JetsonLM"), which Golfinator shows
    in its header.
2026-11-07 Calibration: archive 2026-08-08 set to 2026-08-08_bolted/ for recapture
    The cameras were re-aimed on their screws while moving into a reprinted
    enclosure, so the pair's relative pose changed. cam1/ and cam2/ are freed
    for the new capture; intrinsics and extrinsics get re-solved together.
2026-11-07 Dashboard: Golfinator look, cached stats like the simulator, power-off button
    The statistics page is rebuilt on Golfinator's statistics page: player pill,
    period (session / 30 days / all), club chips, shot table, averages per club
    with spreads, and the dispersion plot with 68 % ellipses. Numbers come from
    dashboard_stats.py with Golfinator's definitions (metric, sample standard
    deviation from 2 shots, covariance ellipse from 3); the look is shared with
    the calibration page through look.py.
    The header carries a "Herunterfahren" button. POST /api/system/shutdown
    (needs the X-JetsonLM header, so a stray web page cannot trigger it) runs
    systemctl poweroff through a sudoers drop-in written once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
2026-11-07 Dashboard: the power-off button asks first
    A stray tap on a phone must not switch the Jetson off. The button opens a
    dialog ("Herunterfahren?", Abbrechen / Herunterfahren; Esc and a click
    beside it cancel); only its confirm sends the request. A refusal comes back
    to the dialog with the reason.
2026-11-07 Dashboard: CSV exports as pill buttons with a download icon
    The muted "CSV" label read like a disabled control.
2026-11-10 Calibration: re-solve after the enclosure reprint, 32 pairs on a flat board
    The cameras were re-aimed on their screws when the plate moved into the
    reprinted enclosure, so intrinsics and extrinsics were re-solved together
    from one new set (--square-mm 24.27, tools' output unchanged):
    fx 916.85 / 918.70, baseline 80.47 mm, pitch -0.442, yaw +0.577,
    roll +0.278 deg.
    Whole-chain subset solves move triangulated board positions by a median
    1-5 mm against the full set; the 2026-08-08 set moves 10-12 mm under the
    same test. A first attempt the same day with a bowing board (fx 951) is
    kept in 2026-11-10_bent_board/ as the record of that failure mode.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
2026-11-10 SP1: first strobe-lit captures, strobe_capture.py and results
    strobe_capture.py streams both cameras at 120 fps, fires one Teensy pulse
    from Pin 29 mid-stream and logs every frame's arrival time after the fire
    and its rise over the ambient baseline.
    First run (room light, ball on the floor): the flash puts 50-100x more
    light on the ball than the room lamps; fire to frame arrival is 11-20 ms;
    8 ms exposure catches every flash, short exposures only by chance, and the
    two cameras are not in phase with each other - the constraint for the
    cam2 trigger design. Three hardware faults found on the way (LED supply
    connector, Cenpek photocells, the Pin 29 trigger line) are recorded in
    sp1_vision/strob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
2026-11-11 SP1 strobe: fixes verified, camera image processor adapts in manual mode
    After desoldering the Cenpek photocells and re-soldering the Pin 29 trigger
    line: 12/12 flashes arrive and both cameras see the ball within 1-2 %;
    a 0.1 ms flash already puts it mid-range.
    Under bright room lamps the flash's contribution dropped (cam1 +116 -> +53,
    cam2 -> +18) and cam2 showed a fixed dark patch over the image centre. Not
    the arrays, cabling or focus: the modules' built-in image processor keeps
    adapting with exposure on manual and got stuck; one auto-exposure pass
    reset it (+108 / +115). Before brightness measurements, settle on auto
    exposure first, then go manual.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
2026-11-11 SP1 strobe: camera tone curve, gamma 72 and auto-settle in strobe_capture
    The flash contribution that shrank under bright lamps is a fixed,
    compressive tone curve in the camera modules, not ongoing adaptation:
    the higher ambient puts the ball on the curve, the fewer grey levels the
    same flash adds. A gamma sweep shows 72 (the control's minimum) as the
    straightest curve (doubled flash -> 1.75x, against 1.65x at the default
    100). Separately, cam2 once stuck with a dark centre patch until an
    auto-exposure pass reset it.
    strobe_capture.py now settles each camera on auto exposure before going
    manual, measures at gamma 72 (restoring 100 afterwards), and reports the
    flash contribution at the ball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
2026-11-11 SP1: first triangulation under the flash, strobe_pair.py
    strobe_pair.py captures one strobe-lit stereo pair per call into a
    cli_triangulate run directory: 8 ms exposure, 0.2 ms flash, gamma 72, an
    auto-exposure pass first, and the shot saved as flash minus ambient so
    room-lit clutter (the patterned carpet) drops out. The existing
    cli_triangulate --analyse reads it unchanged.
    First run, 5 depth + 2 spread positions: scale against the tape
    1.0003 +- 0.0067, residual 1.6 mm over 300-700 mm, so the 2026-11-10
    calibration holds under the flash. Attitude in the reprinted enclosure:
    pitch +1.60 deg, roll +0.36 deg, camera 1 111.9 mm above the floor.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
2026-11-11 SP1: continuous strobe and shot finding afterwards - first putts measured
    The UVC cameras free-run and deliver frames 11-20 ms late, so reacting to a
    hit is impossible. Instead the Teensy strobes continuously while armed,
    both cameras stream into memory, and the shot is found afterwards.
    - Teensy firmware: RUN[,max_ms] / STOP repeat the active pulse list with a
    safety timeout and a 25 % duty limit; existing commands unchanged.
    flash_teensy.sh flashes from the Jetson with PJRC's teensy_loader_cli 2.3
    built from source (Ubuntu's 2.1 predates the Teensy 4.0);
    install_teensy_loader.sh sets up libusb-dev and the udev rule.
    - strobe_shot.py records under the strobe and saves every frame's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
2026-11-11 CLAUDE.md: drivers in scope for v1 - the flash is the shutter; next-session order
2026-11-12 B0332 trigger input works; spin reads dimples, not marks; strobe_event linear
    - LOGBOOK: the UC-844 board's F pad is a 3.3 V input (~3 kOhm pull-up);
    exposure_auto_priority=1 puts the camera in trigger mode and it then
    delivers frames only on a rising edge at F (tested by hand). S is dead
    in free-running mode.
    - CLAUDE.md / LOGBOOK: "spin requires marked balls" was never PiTrac's -
    its GetBallRotation reads the dimples with Gabor filters and marks
    disturb it. Open: whether our optics resolve the dimples.
    - strobe_event.find_impacts: each search stops shortly after the next rest
    detection at the same spot. A ball that never left rescanned to the end
    for every rest sample - quadr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
2026-11-12 Camera trigger: Teensy firmware v0.2 and the flash-delay sweep
    - teensy_strobe.ino v0.2: CAM1_TRIG = pin 4, CAM2_TRIG = pin 5 to the B0332
    F pads. TRIG_ARM / TRIG_DISARM drive or release them (released = inputs,
    cameras untouched); SHOT,mask,delay_us,pulse_us pulls the lines low 10 us,
    the rising edge is t0, one flash at t0 + delay (cycle counter). Pulse
    <= 1 ms, >= 5 ms between shots, refused during RUN. Smoke-tested on the
    Teensy: all replies and limits as specified.
    - sp1_vision/trigger_sweep.py: both cameras in trigger mode at 1 ms
    exposure, flash/no-flash shot pairs over delays 0-20 ms, frames matched to
    shots by arrival time, a one-shot-late (held-back) frame detected fro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
2026-11-12 Trigger measured: exposure 0.78 ms after the edge, both cameras within 25 us
    trigger_sweep analysis: flash minus the following dark shot at the same
    delay (room flicker lit dark shots as brightly as the flash), mean
    brightening instead of a 99th percentile, and "seen" as >= 1 grey level
    above the noise floor - percentile and two-cluster thresholds fell
    between groups of real flashes. Results in LOGBOOK.
2026-11-12 CLAUDE.md: the B0332 hardware trigger, wired and measured
2026-11-12 Continuous camera trigger: firmware v0.3 TRIG_RUN, rate test, strobe_shot --trigger
    - teensy_strobe.ino v0.3: TRIG_RUN,period_us,delay_us,pulse_us[,max_ms]
    repeats SHOT's edge + flash on a fixed period until STOP (returns the
    edge count) or max_ms; RUN's guards plus period >= 5 ms and delay+pulse
    fitting the period. Edge + flash code shared with SHOT.
    - trigger_rate.py: both cameras follow every edge at 100 fps (301/301);
    at 105 fps and above they take exactly every other edge.
    - strobe_shot --trigger: trigger mode, 0.5 ms exposure, edge every 10 ms,
    flash 0.9 ms after it. 3 s test: 309 edges, 309 frames per camera.
    - strobe_capture.set_trigger_mode shared by all three.
    Co-Authore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
2026-11-12 Docs: continuous trigger, 100 fps limit, triggered chips recorded
    LOGBOOK, CLAUDE.md (next-session order) and strobe_runs/README: TRIG_RUN
    works, both cameras follow every edge at 100 fps and every other one above;
    triggered chips show one sharp ball per frame; strobe_event still needs
    adapting to the dimmer triggered frames (rest search 4/180, flight search
    stopped after 34 min on chip 1).
2026-11-13 strobe_event: read triggered recordings - no noise blow-up, brighten dark frames
    Measured on the 2026-11-12 triggered chips before changing anything:
    - flight search: a ball-free difference image has ~9 grey levels of noise
    at its 99.9th percentile; scaled to 220 that gave 1768 x 1577 Hough
    circles and ~280 s of pairing per frame (frames with the ball: 6 x 8,
    0.3 s). The scale now has a floor (POSITIVE_MIN_TOP = 100; ball frames
    sit near 100 anyway), and find_ball_pair takes max_candidates so a noise
    image is refused before pairing.
    - rest search: the rest ball is 78 on 24 but its edge is soft (Sobel
    median 19, Canny threshold 100) - found in 0 of 17 moments; frames with
    a medi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
2026-11-13 Flight search: a ball in flight may climb over the optical axis
    find_ball_pair(in_flight=True) keeps depth and lateral bounds but drops the
    resting-ball height band (20-200 mm below the axis), keeping only "not below
    the surface". On the 2026-11-12 triggered chips the ball was located to
    0.1-0.4 px with matching radii at Y = -23 / -45 / -66 mm and refused only by
    that band. strobe_event's flight search sets it; the rest search does not.
    Result on 2026-11-12_chips_trigger (147 s): chip 1 4.82 m/s, 7 of 7 on the
    line, rms 5.5 mm; chip 3 3.91 m/s, 7 of 8, rms 6.4 mm; chip 2 4.86 m/s but
    5 of 6 (minimum 6) - the ball leaves the IR beam, its residual falls
    106 -> 9 over 0.1 s while still well in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
2026-11-13 Short-pulse test redone on aligned frames; first run withdrawn
    The first run read "the next frame" after each SHOT; in trigger mode the
    buffer still holds frames from before the switch or from the previous shot
    (a 0/300 us check showed the flash one shot late, differently per camera).
    Redone with frames read continuously, matched by arrival time and proven
    with interleaved dark shots (shift 0, none missing): +17 / +34 / +50 / +75 /
    +123 grey levels at 10 / 20 / 30 / 50 / 100 us, both cameras alike, about
    twice the first run's figures. "No dimples" withdrawn - undecided. Ink
    test: only the thick middle stroke is clearly dark at 850 nm.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
2026-11-13 Dimple test: PiTrac's dimple maps do not carry the rotation - spin via marks
    PiTrac's dimple front-end reproduced on aligned frames of a resting ball
    turned ~10 deg by hand: no score peak at the true turn with the marks
    masked (best +24 / +38 deg, wrong sign, search edge), while the control
    with the pen stroke kept finds the turn (-16..-18 vs -8..-12 deg, sign
    right). Decision recorded in CLAUDE.md known issues 1: IR-dark marks, a
    stencil and a mark-based spin method of our own.
